alexzirnea/bldc_motor_driver_platform/README.md

# bldc_motor_driver_platform
Project repo for BLDC motor driver platform for ETTI
