alexzirnea/bldc_motor_driver_platform/Hardware/Specification/Connector_Pin_Mapping.xlsx

 | BLDC Motor Control Platform Interconnect Specification
Connector Type: PATA 40 Pin 2.54mm pin pitch
 |  | 2 | 4 | 6 | 8 | 10 | 12 | 14 | 16 | 18 | 20 | 22 | 24 | 26 | 28 | 30 | 32 | 34 | 36 | 38 | 40
Female connector |  | PWMAH | PWMBH | PWMCH | SCL | TX | MOSI | LEDR | LEDB | SW1 | HALLA | HALLC | VDD | DGND | TEMP | VBUS | IPHC | IPHA | VPHC | VPHA | AVDD
Board side view |  | PWMAL | PWMBL | PWMCL | SDA | RX | MISO | LEDG | CS2 | SW2 | HALLB | CS | SCK | GPIO | INT | POT | RST | IPHB | VGND | VPHB | AGND
 |  | 1 | 3 | 5 | 7 | 9 | 11 | 13 | 15 | 17 | 19 | 21 | 23 | 25 | 27 | 29 | 31 | 33 | 35 | 37 | 39
