alexzirnea/bldc_motor_driver_platform/Hardware/PIM/ATMEGA_4808/Renders/3D_SIDE.PNG

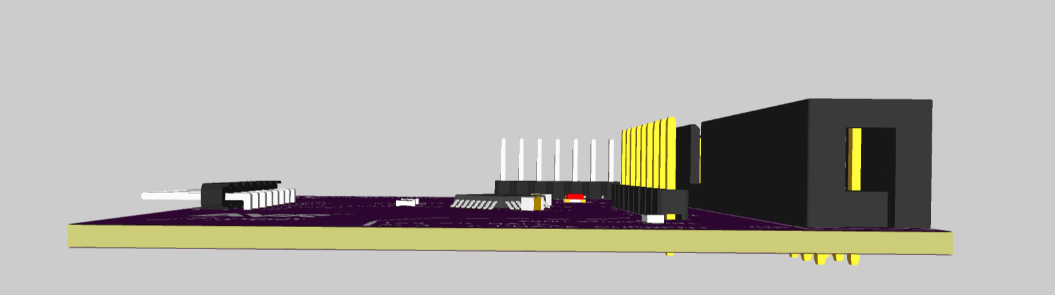
Hardware/PIM/ATMEGA_4808/Renders/3D_SIDE.PNG
