alexzirnea/bldc_motor_driver_platform/Hardware/PIM/ATMEGA_4808/Renders/3D_TOP.PNG

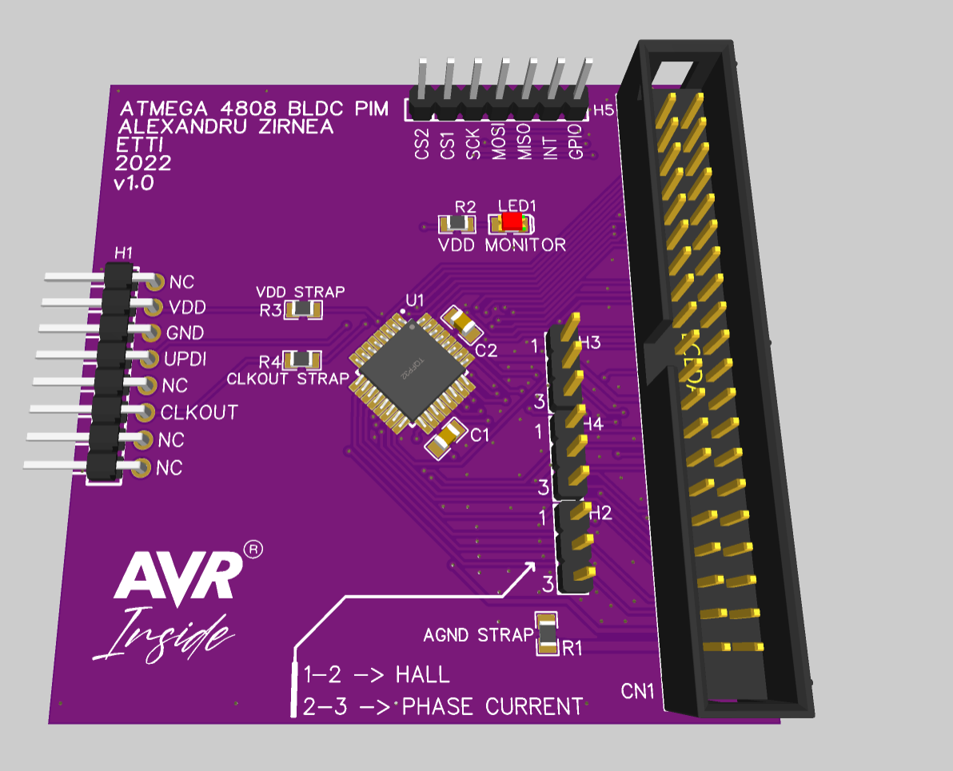
Hardware/PIM/ATMEGA_4808/Renders/3D_TOP.PNG
