alexzirnea/bldc_motor_driver_platform/Hardware/PIM/ESP32-WROOM-32E/Renders/3D_BOTTOM.PNG

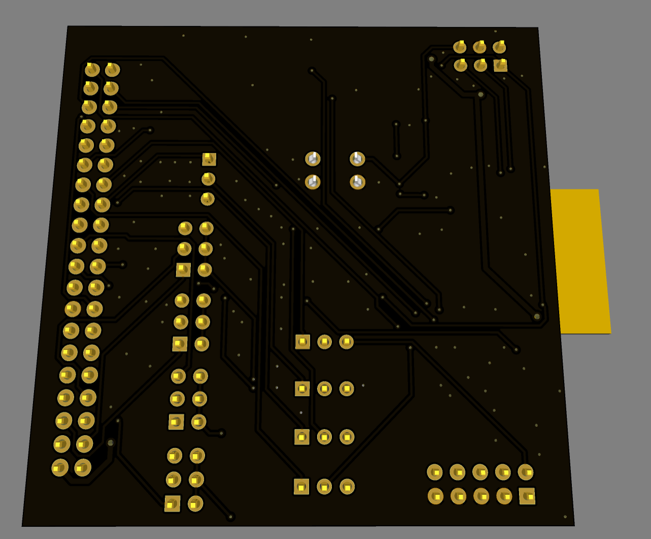
Hardware/PIM/ESP32-WROOM-32E/Renders/3D_BOTTOM.PNG
