alexzirnea/bldc_motor_driver_platform/Hardware/PIM/ESP32-WROOM-32E/Renders/3D_TOP.PNG

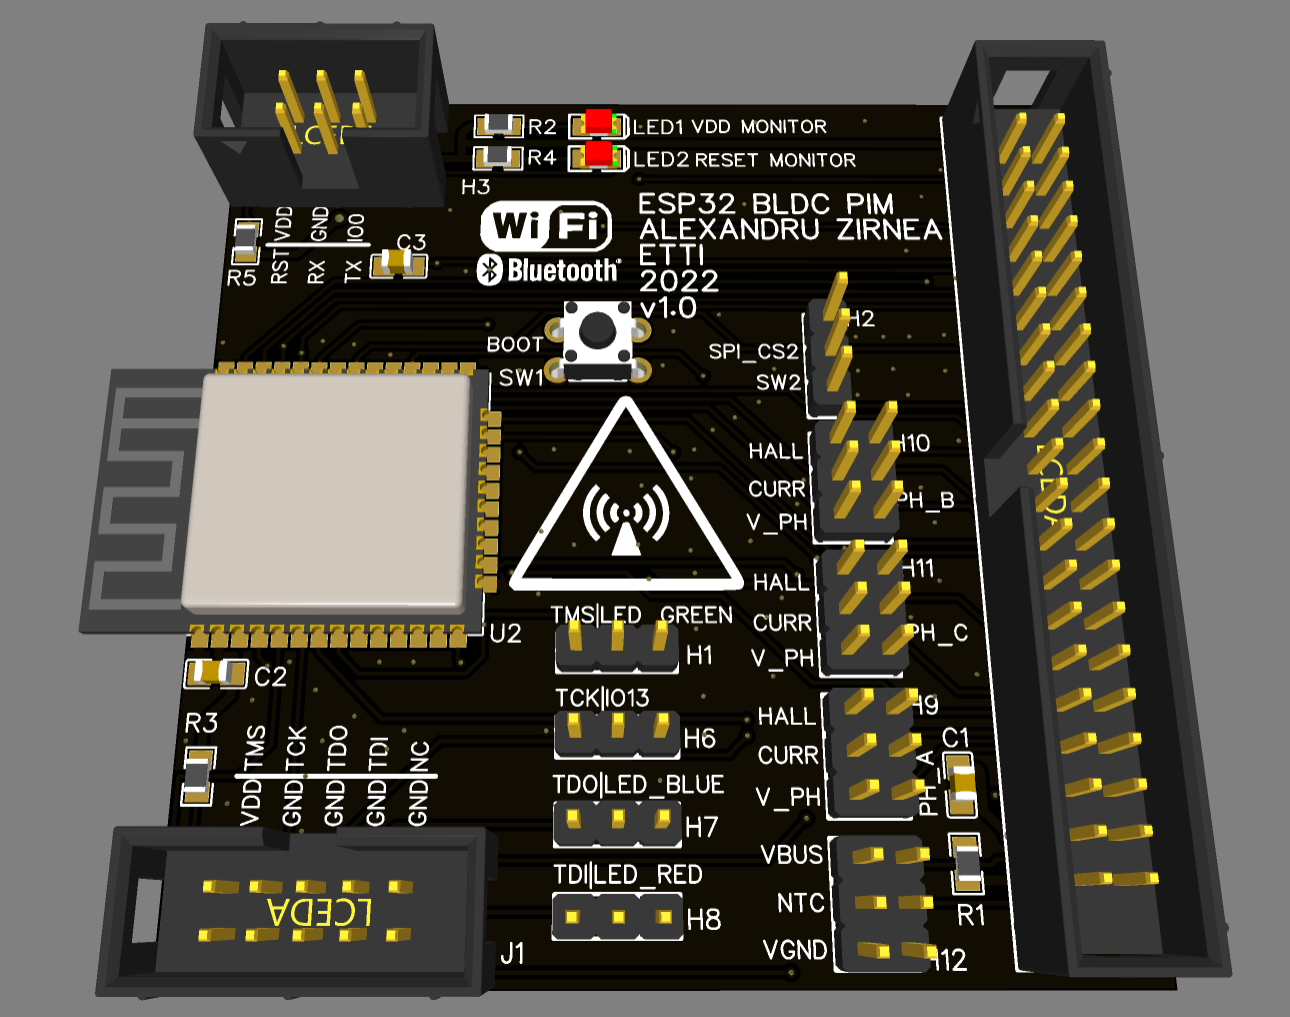
Hardware/PIM/ESP32-WROOM-32E/Renders/3D_TOP.PNG
