alexzirnea/bldc_motor_driver_platform/Hardware/OrCad Project/power_board/BOM.xlsx

ID | Value/Name | Fooprint | Designator | Quantity | Manufacturer Part | Manufacturer | Supplier | Supplier Part | Price[RON] | DNP
1 | 1n | SMC0805 | C1,C2,C3,C4,C5,C6,C43,C46,C52,C55,C59 | 11 | 885012207098 | WURTH Elektronik | MOUSER | 710-885012207098 | 0.495
2 | 100n | SMC0805 | C7,C8,C9,C10,C23,C27,C30,C33,C36,C47 | 10 | 885012107015 | WURTH Elektronik | MOUSER | 710-885012107015 | 0.495
3 | 10u | CAPC5750X330N | C11,C12,C13,C14,C15,C16,C17,C18,C19,C20,C21,C22,C42,C51 | 14 | 22201C106KAT2A | Kyocera AVX | MOUSER | 581-22201C106KAT2A | 10.2
4 | 1u | SMC0805 | C24,C25,C26,C44,C45,C53,C54 | 7 | 885012107015 | WURTH Elektronik | MOUSER | 710-885012107015 | 0.495
5 | 1u | SMC0805 | C50 | 1 | CGA4J3X7S2A105KS | TDK | MOUSER | 810-CGA4J3X7S2A105KS | 2.03
6 | 47u | SMC1206 | C28,C31,C34,C48,C58 | 5 | CL31A476MQHNNNE | Samsung Electro-Mechanics | MOUSER | 187-CL31A476MQHNNNE | 1.58
7 | 10u | SMC0805 | C29,C32,C35 | 3 | CL21A106KAYNNNF | Samsung Electro-Mechanics | MOUSER | 187-CL21A106KAYNNNF | 0.941
8 | 2.2u | SMC0805 | C37,C41 | 2 | CL21A225KAFNNNG | Samsung Electro-Mechanics | MOUSER | 187-CL21A225KAFNNNG | 0.594
9 | 560u | CAP_EEEFT1V561AP | C38,C49 | 2 | EEE-FT1V561AP | Panasonic | MOUSER | 667-EEE-FT1V561AP | 7.62
10 | 10n | SMC0805 | C39,C40 | 2 | 08051C103KAT2A | KEMET | MOUSER | 581-08051C103K | 0.594
11 | 2200u 63V | UPW1J222MHD | C56,C57 | 2 | UPW1J222MHD | Nichicon | MOUSER | 647-UPW1J222MHD | 17.87
12 | BAT54 | SMSOT23123 | DN1,DN2,DN3,DN4 | 4 | BAT54S-QR | Nexperia | MOUSER | 771-BAT54S-QR | 0.941
13 | MBRS1100T3G | DIOM5436X247N | D1,D2,D3 | 3 | MBRS1100T3G | onsemi | MOUSER | 863-MBRS1100T3G | 2.87
14 | LL-R3528RGBC-008-B | LED_LL-R3528RGBC-008-B | D4 | 1 | AAA3528LSEKJ3ZGKQBKS | Kingbright | MOUSER | 604-AAA3528LSEKJ3ZGK | 4.41
15 | LED | SMD0805 | D5,D6,D7,D8,D9,D10,D21,D22,D23,D24,D25 | 11 | 150080GS75000 | WURTH Elektronik | MOUSER | 710-150080GS75000 | 0.941
16 | SS26FL | DIO_SS26FL | D11,D12,D13,D14,D15,D16 | 6 | SS26FL | onsemi | MOUSER | 512-SS26FL | 1.78
17 | BAT41 | SOD3716X135N | D17,D19 | 2 | BAT41ZFILM | ST Microelectronics | MOUSER | 511-BAT41ZFILM | 1.78
18 | MMSZ7V5T1G | SOD3716X135N | D18 | 1 | MMSZ7V5T1G | onsemi | MOUSER | 863-MMSZ7V5T1G | 1.14
19 | 15KP48CA | DIOAD885W125L910D885 | D20 | 1 | 15KP48CA-TP | MCC | MOUSER | 833-15KP48CA-TP | 62.22
20 | INA240A2EDRQ1 | SOIC127P600X175-8N | IC1,IC2,IC3 | 3 | INA240A2EDRQ1 | Texas Instruments | MOUSER | 595-INA240A2EDRQ1 | 21.48
21 | MIC4104YM | SOIC127P599X173-8N | IC4,IC5,IC6 | 3 | MIC4104YM | Microchip Technology | MOUSER | 998-MIC4104YM | 14.11
22 | MCP16331T-E_CH | SOT95P280X145-6N | IC7 | 1 | MCP16331T-E/CH | Microchip Technology | MOUSER | 579-MCP16331T-E/CH | 8.81
23 | PHASE A | power_pad | J1 | 1 | N/A - Connection wires | N/A - Connection wires | N/A - Connection wires | N/A - Connection wires | 0
24 | PHASE B | power_pad | J2 | 1 | N/A - Connection wires | N/A - Connection wires | N/A - Connection wires | N/A - Connection wires | 0
25 | PHASE C | power_pad | J3 | 1 | N/A - Connection wires | N/A - Connection wires | N/A - Connection wires | N/A - Connection wires | 0
26 | HEADER 1x2 | BLKCON100VHTM1SQW1002 | J4,J5,J6,J32,J33,J34,J37,J39 | 8 | TSW-102-07-T-S | SAMTEC | MOUSER | 200-TSW10207TS | 0.792
27 | HEADER 4 | BLKCON100VHTM1SQW1004 | J7,J8 | 2 | 69190-404 | Amphenol FCI | MOUSER | 649-69190-404 | 1.24
28 | JUMPER1 | BLKCON100VHTM1SQW1002 | J9 | 1 | TSW-102-07-T-S | SAMTEC | MOUSER | 200-TSW10207TS | 0.792
29 | CON6 | BLKCON100RHTM1SQW4256 | J10 | 1 | 77313-446-06LF | Amphenol FCI | MOUSER | 649-77313-446-06LF | 1.49
30 | 30340-5002HB | BLKCON100VHTM2OEW20040 | J11 | 1 | 61204021621 | WURTH Elektronik | MOUSER | 710-61204021621 | 5.99
31 | HEADER 4X2 | BLKCON100VHTM2OEW2008 | J12,J13,J14,J15,J17 | 5 | 79425-408HLF | Amphenol FCI | MOUSER | 649-79425-408HLF | 1.63
32 | 10129381-906002BLF | HDRV6W67P254_2X3_762X483X858P | J16 | 1 | 77313-446-06LF | Amphenol FCI | MOUSER | 649-77313-446-06LF | 1.49
33 | CON5 | BLKCON100VHTM1SQW1005 | J18 | 1 | 54101-T06-05 | Amphenol FCI | MOUSER | 649-54101-T06-05 | 1.09
34 | CON3 | BLKCON100VHTM1SQW1003 | J19,J20,J21,J22 | 4 | 61300311121 | WURTH Elektronik | MOUSER | 710-61300311121 | 0.644
35 | CON1 | BLKCON100VHTM1SQW1001 | J23,J25,J26,J27,J28,J29,J30 | 7 | 4952 | Keystone | MOUSER | 534-4952 | 1.29
36 | HEADER 5X2 | BLKCON100VHTM2OEW20010 | J24 | 1 | 61201021621 | WURTH Elektronik | MOUSER | 710-61201021621 | 2.38
37 | CON11 | ili9341_2_8inch | J31 | 1 | 801-83-011-10-001101 | SAMTEC | MOUSER | 437-8018301110001101 | 9.41
38 | VIN | power_pad | J35 | 1 | N/A - Connection wires | N/A - Connection wires | N/A - Connection wires | N/A - Connection wires | 0
39 | GND | power_pad | J36 | 1 | N/A - Connection wires | N/A - Connection wires | N/A - Connection wires | N/A - Connection wires | 0
40 | HEADER 3 | BLKCON100VHTM1SQW1003 | J38 | 1 | 61300311121 | WURTH Elektronik | MOUSER | 710-61300311121 | 0.644
41 | 100u | INDM1250X1250X600 | L1 | 1 | SLF12575T-101M1R9-PF | TDK | MOUSER | 810-SLF12575T-101M | 9.95
42 | 100uH | INDP125125X785N | L2 | 1 | SLF12575T-101M1R9-PF | TDK | MOUSER | 810-SLF12575T-101M | 9.95
43 | IPB039N10N3_G | PG-TO263-3 | Q1,Q2,Q3,Q4,Q5,Q6 | 6 | IPB039N10N3G | Infineon | MOUSER | 726-IPB039N10N3G | 17.18
44 | 10k NTC | SMR0805 | RT1 | 1 | NTCS0805E3103HLT | Vishay | MOUSER | 594-NTCS0805E3103HLT | 3.56
45 | 47k | SMR0805 | R1,R2,R3,R4,R5,R6,R79,R80 | 8 | 667-ERJ-6ENF4702V | Panasonic | MOUSER | 667-ERJ-6ENF4702V | 0.495
46 | 5.1k | SMR0805 | R7,R8,R9,R81 | 4 | CRCW08055K10FKEA | Vishay | MOUSER | 71-CRCW0805-5.1K-E3 | 0.495
47 | 3.3R | SMR1210 | R10,R13,R15 | 3 | RK73B2ETTD3R3J | KOA Speer | MOUSER | 660-RK73B2ETTD3R3J | 0.945
48 | 110k | SMR0805 | R11,R12,R14,R71,R72 | 5 | CR0805FX-1103ELF | Bourns | MOUSER | 652-CR0805FX-1103ELF | 0.495
49 | 1k | SMR0805 | R16,R17,R74 | 3 | CRT0805FZ1001ELF | Bourns | MOUSER | 652-CRT0805FZ1001ELF | 0.495
50 | 2k2 | SMR0805 | R18,R20,R21 | 3 | CR0805JW-222ELF | Bourns | MOUSER | 652-CR0805JW-222ELF | 0.495
51 | 3k3 | SMR0805 | R19,R22,R23 | 3 | CRCW08053K30JNEB | Vishay | MOUSER | 71-CRCW08053K30JNEB | 0.495
52 | 10k | SMR0805 | R24,R29,R32,R40,R48,R49,R55,R56,R61,R62,R68,R73 | 12 | CRGCQ0805F10K | TE Connectivity | MOUSER | 279-CRGCQ0805F10K | 0.495
53 | 330R | SMR0805 | R25,R26,R27,R30,R31,R33,R34,R35,R36,R75,R76,R77,R78 | 13 | RC0805FR-07330RL | YAGEO | MOUSER | 603-RC0805FR-07330RL | 0.495
54 | 10k | RK09D117000B | R28 | 1 | RK09D117000B | Alps | MOUSER | 688-RK09D117000B | 10.15
55 | 0.001R | CSS2H-3920R | R37,R38,R39 | 3 | CSS2H-3920R-1L00F | Bourns | MOUSER | 652-CSS2H3920R1L00F | 6.29
56 | 0R | SMR0805 | R41,R42,R43 | 3 | CR0805-J/-000ELF | BOURNS | MOUSER | 652-CR0805-J/-000ELF | 0.495
57 | 20R | SMR0805 | R44,R47,R52,R57,R60,R65 | 6 | RC0805FR-0720RL | YAGEO | MOUSER | 603-RC0805FR-0720RL | 0.495
58 | 5R | SMR0805 | R45,R50,R53,R58,R63,R66 | 6 | CR0805-J/-5R1ELF | BOURNS | MOUSER | 652-CR0805-J/-5R1ELF | 0.495
59 | 330k | SMR0805 | R46,R51,R54,R59,R64,R67 | 6 | AC0805FR-07330KL | YAGEO | MOUSER | 603-AC0805FR-07330KL | 0.495
60 | 402k | SMR0805 | R69 | 1 | CR0805FX-4023ELF | BOURNS | MOUSER | 652-CR0805FX-4023ELF | 0.495
61 | 2k | SMR0805 | R70 | 1 | CR0805AFX2001EAS | BOURNS | MOUSER | 652-CR0805AFX2001EAS | 0.495
62 | B3F-1000 | SW_B3F-1000 | SW1,SW2,SW3 | 3 | TS02-66-55-BK-100-LCR-D | CUI Devices | MOUSER | 179-TS026655BK100LCR | 0.495
63 | NRF24L01P-MODULE-PCB | XCVR_NRF24L01P-MODULE-PCB | U1 | 1 | CES-104-02-T-D | Samtec | MOUSER | 200-CES10402TD | 6.09
64 | LM5161PWPR | IC_TPS27S100BPWPR | U2 | 1 | LM5161PWPR | Texas Instruments | MOUSER | 595-LM5161PWPR | 24.21
65 | AMS1117-5V | SOT229P700X180-4N | U3 | 1 | LDL1117S50R | ST Microelectronics | MOUSER | 511-LDL1117S50R | 5.74
66 | AMS1117-33 | SOT229P700X180-4N | U4 | 1 | LDL1117S33R | ST Microelectronics | MOUSER | 511-LDL1117S33R | 5.74
