alexzirnea/bldc_motor_driver_platform/Hardware/PIM/ATMEGA_4808/BOM.xlsx

ID | Name | Designator | Footprint | Quantity | Manufacturer Part | Manufacturer | Supplier | Supplier Part | Price[RON] | DNP
1 | 0.1u | C1,C2 | C0805 | 2 | 885012207098 | WURTH Elektronik | MOUSER | 710-885012207098 | 0.495
2 | CS-1200-40(L11.6)6T | CN1 | CONN-TH_40P-P2.54_CST_CS-1200-40XXX6T | 1 | 61204021621 | WURTH Elektronik | MOUSER | 710-61204021621 | 5.99
3 | MPLAB SNAP 2.54 HORIZ MALE | H1 | HDR-TH_8P-P2.54-H-M-W10.4-N | 1 | 10129379-908001BLF | Amphenol FCI | MOUSER | 649-1012937990801BLF | 1.14
4 | KH-2.54FH-1X3P-H8.5 | H2,H3,H4 | HDR-TH_3P-P2.54-V-F | 3 | 61300311121 | WURTH Elektronik | MOUSER | 710-61300311121 | 0.644
5 | KH-2.54FH-1X7P-H8.5 | H5 | HDR-TH_7P-P2.54-V-F | 1 | 10129379-907001BLF | Amphenol FCI | MOUSER | 649-1012937990701BLF | 1.09
6 | LED-0603_R | LED1 | LED0805_RED | 1 | 150080RS75000 | WURTH Elektronik | MOUSER | 710-150080RS75000 | 0.941
7 | 0R | R1 | R0805 | 1 | CR0805-J/-000ELF | BOURNS | MOUSER | 652-CR0805-J/-000ELF | 0.495
8 | 330R | R2 | R0805 | 1 | RC0805FR-07330RL | YAGEO | MOUSER | 603-RC0805FR-07330RL | 0.495
9 | 0R | R3,R4 | R0805 | 2 | CR0805-J/-000ELF | BOURNS | MOUSER | 652-CR0805-J/-000ELF | 0.495 | TRUE
10 | ATmega4808-AFR | U1 | 32-TQFP | 1 | ATMEGA4808-AFR | Microchip | MOUSER | 579-ATMEGA4808AFR | 9.31
