alexzirnea/bldc_motor_driver_platform/Hardware/PIM/ESP32-WROOM-32E/BOM.xlsx

ID | Name | Designator | Footprint | Quantity | Manufacturer Part | Manufacturer | Supplier | Supplier Part | Price[RON] | DNP
1 | 1u | C1,C2 | C0805 | 2 | 885012107015 | WURTH Elektronik | MOUSER | 710-885012107015 | 0.495
2 | 0.1u | C3 | C0805 | 1 | 885012207098 | WURTH Elektronik | MOUSER | 710-885012207098 | 0.495
3 | CS-1200-40(L11.6)6T | CN1 | CONN-TH_40P-P2.54_CST_CS-1200-40XXX6T | 1 | 61204021621 | WURTH Elektronik | MOUSER | 710-61204021621 | 5.99
4 | KH-2.54FH-1X3P-H8.5 | H1,H2,H6,H7,H8 | HDR-TH_3P-P2.54-V-F | 5 | 61300311121 | WURTH Elektronik | MOUSER | 710-61300311121 | 0.644
5 | 210-72-03GB01 | H3 | HDR-TH_6P-P2.54-V-R2-C3-S2.54_A2541WV-2X3P | 5 | 61200621621 | WURTH Elektronik | MOUSER | 710-61200621621 | 2.38
6 | 210-72-03GB01 | H9,H10,H11,H12 | HDR-TH_6P-P2.54-V-R2-C3-S2.54_A2541WV-2X3P | 5 | 77313-446-06LF | Amphenol FCI | MOUSER | 649-77313-446-06LF | 1.49
7 | F185-1210A0BSYA1 | J1 | H2X5-2.54 | 1 | 61201021621 | WURTH Elektronik | MOUSER | 710-61201021621 | 2.38
8 | LED-0603_R | LED1,LED2 | LED0805_RED | 2 | 150080RS75000 | WURTH Elektronik | MOUSER | 710-150080RS75000 | 0.941
9 | 0R | R1 | R0805 | 1 | CR0805-J/-000ELF | BOURNS | MOUSER | 652-CR0805-J/-000ELF | 0.495
10 | 330R | R2,R4 | R0805 | 2 | RC0805FR-07330RL | YAGEO | MOUSER | 603-RC0805FR-07330RL | 0.495
11 | 0R | R3,R5 | R0805 | 2 | CR0805-J/-000ELF | BOURNS | MOUSER | 652-CR0805-J/-000ELF | 0.495 | TRUE
12 | TSC016A03526A | SW1 | KEY-TH_4P-L4.5-W4.5-P3.00-LS5.8 | 1 | TS02-66-55-BK-100-LCR-D | CUI Devices | MOUSER | 179-TS026655BK100LCR | 0.495
13 | ESP32-WROOM-32 | U2 | WIFIM-SMD_ESP-32S | 1 | ESP32-WROOM-32E-N4 | Espressif Systems | MOUSER | 356-ESP32WRM32E132PH | 14.85
