alexzirnea/bldc_motor_driver_platform/Hardware/OrCad Project/parts/B3F-1000.STEP

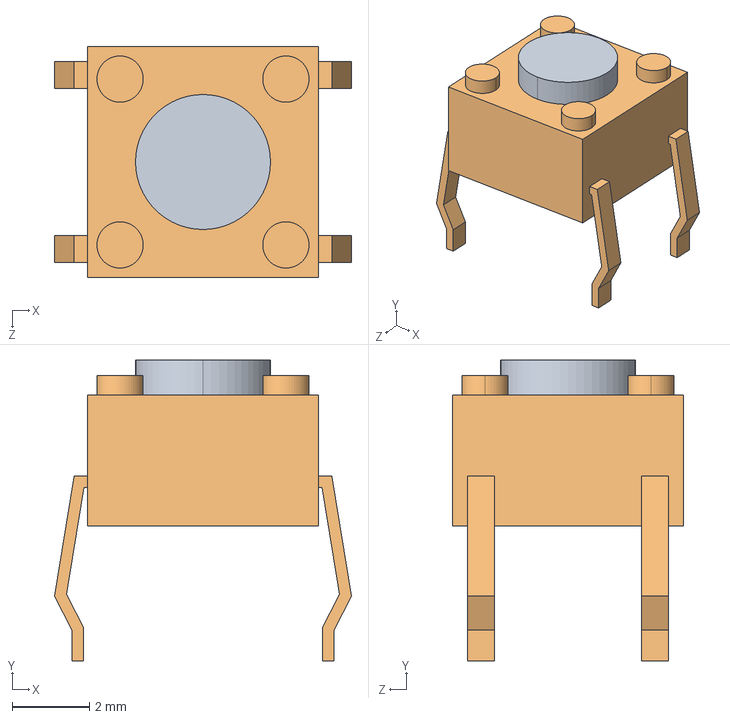
[picture p7: CAD file, 2022-05-20]
Hardware/OrCad Project/parts/B3F-1000.STEP
7.70 x 7.80 x 6.00 mm
B3F_1000_BUTTON
B3F_1000_BASE
