alexzirnea/bldc_motor_driver_platform/Hardware/OrCad Project/parts/DIOAD885W125L910D885.STEP

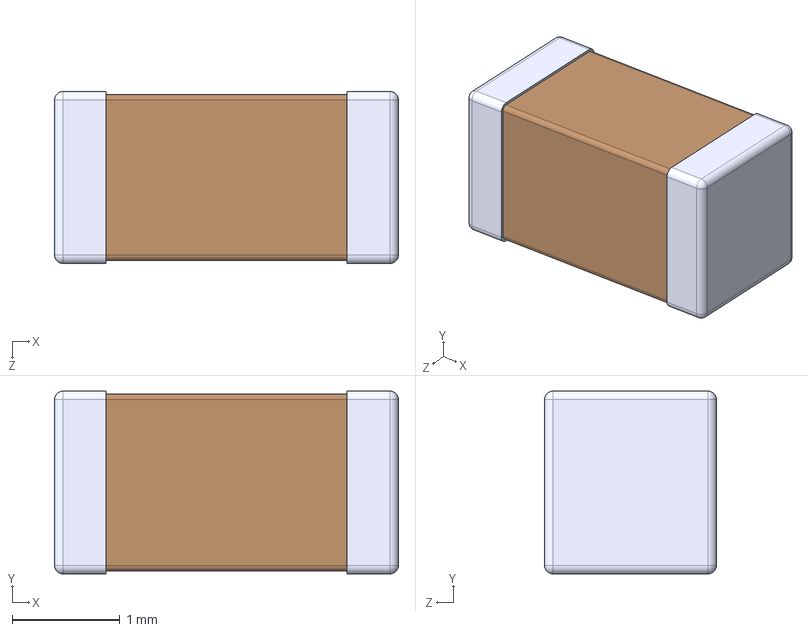
[picture p8: CAD file, 2022-05-19]
Hardware/OrCad Project/parts/DIOAD885W125L910D885.STEP
3.20 x 1.70 x 1.60 mm
