alexzirnea/bldc_motor_driver_platform/Hardware/OrCad Project/parts/LM5161PWPR.STEP

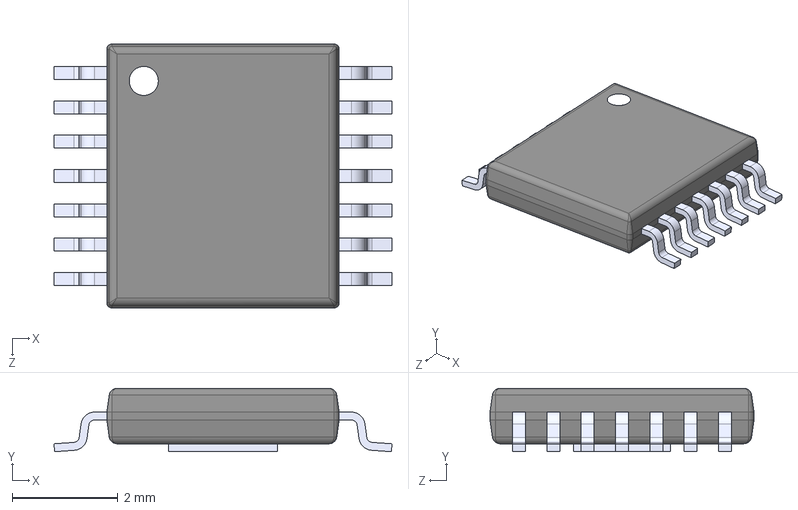
[picture p9: CAD file, 2022-05-16]
Hardware/OrCad Project/parts/LM5161PWPR.STEP
6.40 x 1.20 x 5.00 mm
