alexzirnea/bldc_motor_driver_platform/Hardware/OrCad Project/parts/AMS1117-3.3.STEP

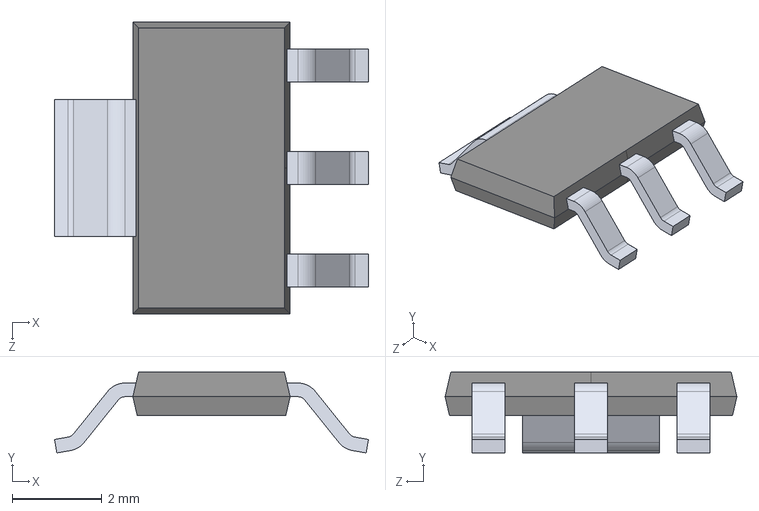
[picture p10: CAD file, 2022-05-16]
Hardware/OrCad Project/parts/AMS1117-3.3.STEP
7.00 x 1.80 x 6.50 mm
