alexzirnea/bldc_motor_driver_platform/Hardware/OrCad Project/parts/LL-R3528RGBC-008-B.STEP

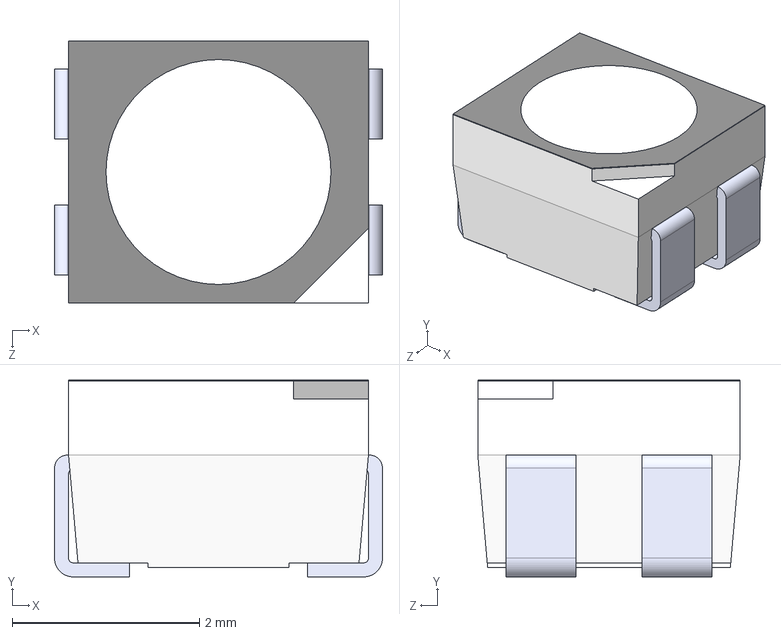
[picture p11: CAD file, 2022-05-16]
Hardware/OrCad Project/parts/LL-R3528RGBC-008-B.STEP
3.50 x 2.10 x 2.80 mm
