alexzirnea/bldc_motor_driver_platform/Hardware/OrCad Project/parts/EEU-FR1C101.stp

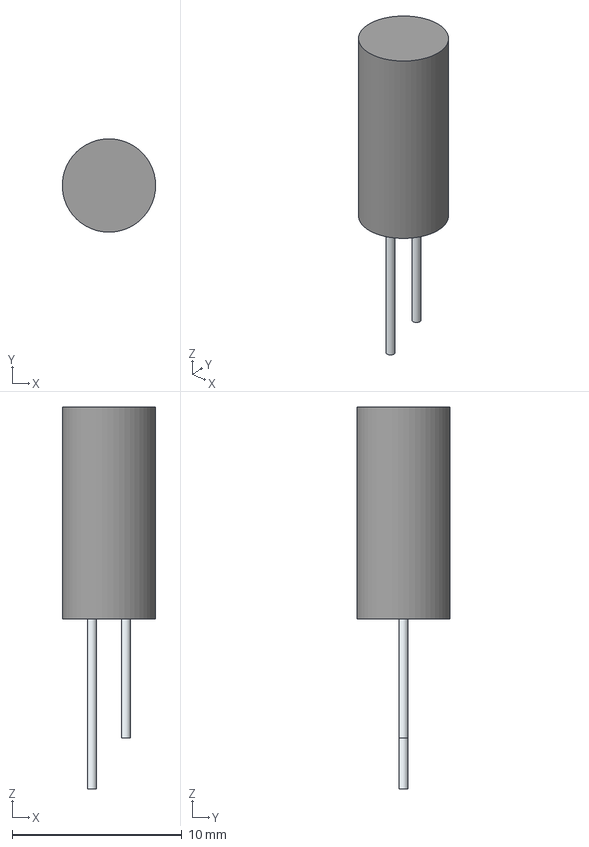
[picture p12: CAD file, 2022-04-29]
Hardware/OrCad Project/parts/EEU-FR1C101.stp
5.49 x 5.50 x 22.5 mm
SimpleBody
Pin1
Pin2
