alexzirnea/bldc_motor_driver_platform/Hardware/OrCad Project/parts/BAT41ZFILM.stp

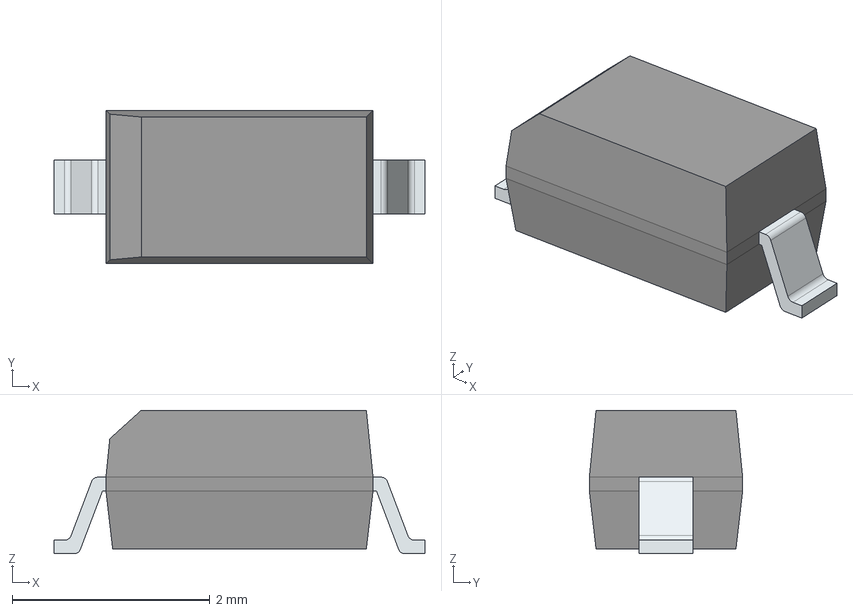
[picture p13: CAD file, 2022-04-29]
Hardware/OrCad Project/parts/BAT41ZFILM.stp
3.75 x 1.55 x 1.45 mm
FilletPinL
FilletPinR
