alexzirnea/bldc_motor_driver_platform/Hardware/OrCad Project/parts/AVR128DA48T-E_PT.stp

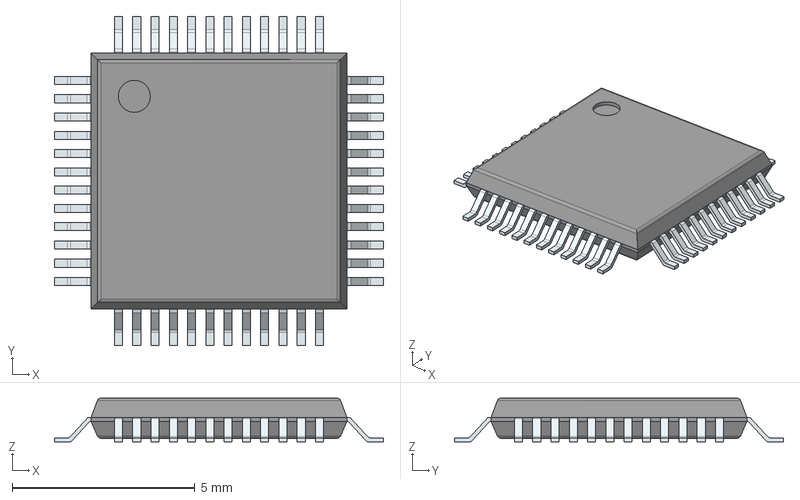
[picture p14: CAD file, 2022-04-29]
Hardware/OrCad Project/parts/AVR128DA48T-E_PT.stp
9.00 x 9.00 x 1.20 mm
PinsArrayLR
PinsArrayTB
