alexzirnea/bldc_motor_driver_platform/Hardware/OrCad Project/parts/B1047AS-680M=P3.stp

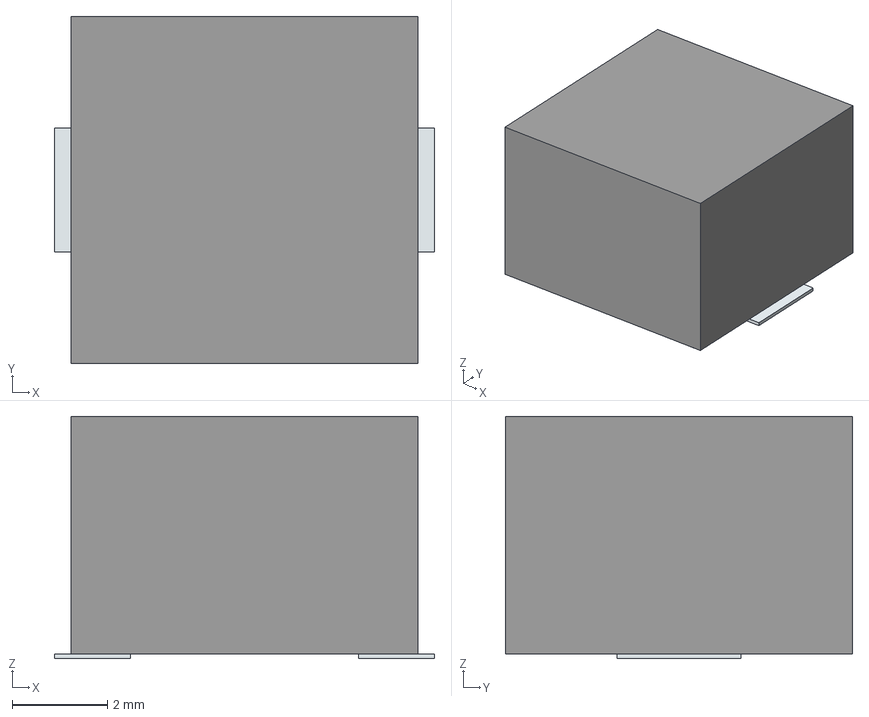
[picture p15: CAD file, 2022-04-29]
Hardware/OrCad Project/parts/B1047AS-680M=P3.stp
8.00 x 7.30 x 5.10 mm
Pins
