alexzirnea/bldc_motor_driver_platform/Hardware/OrCad Project/parts/CSS2H-3920K-4L00F.stp

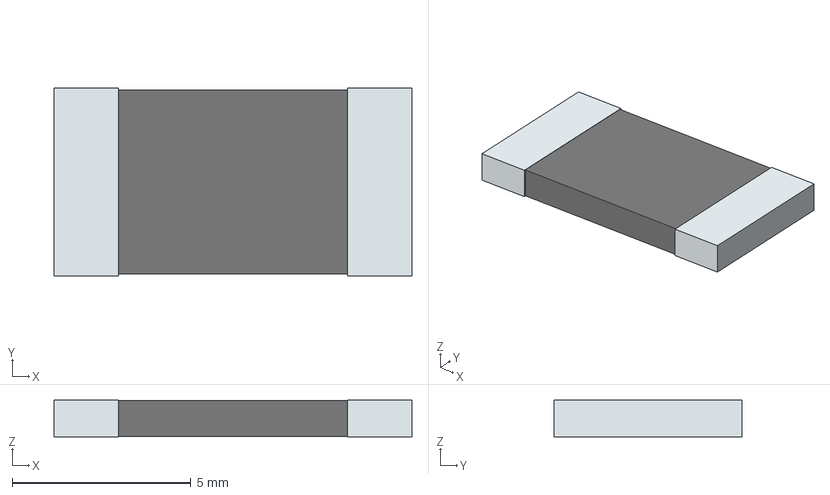
[picture p16: CAD file, 2022-04-29]
Hardware/OrCad Project/parts/CSS2H-3920K-4L00F.stp
10.0 x 5.25 x 1.02 mm
term1
term2
