alexzirnea/bldc_motor_driver_platform/Hardware/OrCad Project/parts/INA240A2EDRQ1.stp

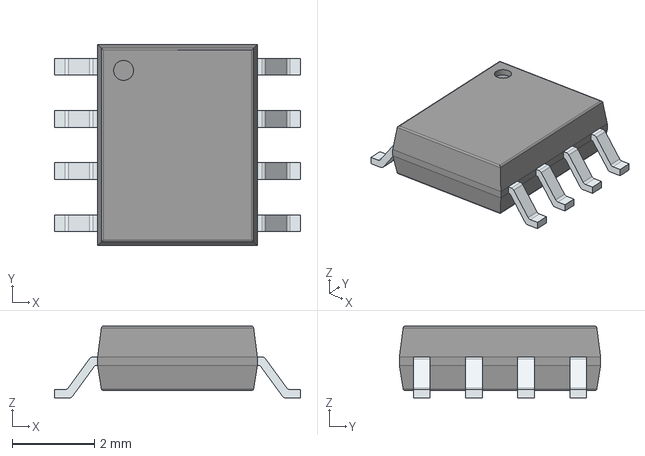
[picture p17: CAD file, 2022-04-29]
Hardware/OrCad Project/parts/INA240A2EDRQ1.stp
6.00 x 4.91 x 1.75 mm
PinsArrayLR
