alexzirnea/bldc_motor_driver_platform/Hardware/OrCad Project/parts/MMSZ7V5T1G.stp

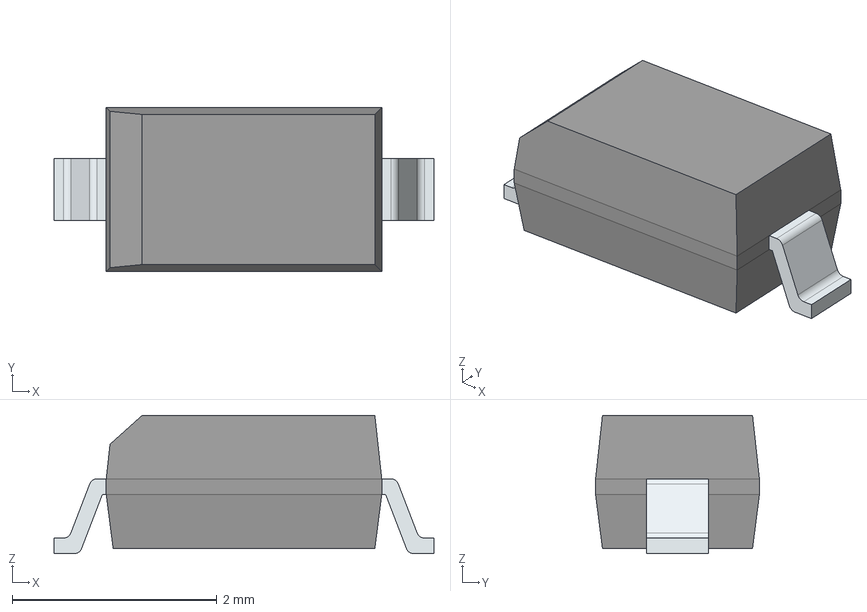
[picture p18: CAD file, 2022-04-29]
Hardware/OrCad Project/parts/MMSZ7V5T1G.stp
3.71 x 1.60 x 1.35 mm
FilletPinL
FilletPinR
