alexzirnea/bldc_motor_driver_platform/Hardware/OrCad Project/parts/SS26FL.stp

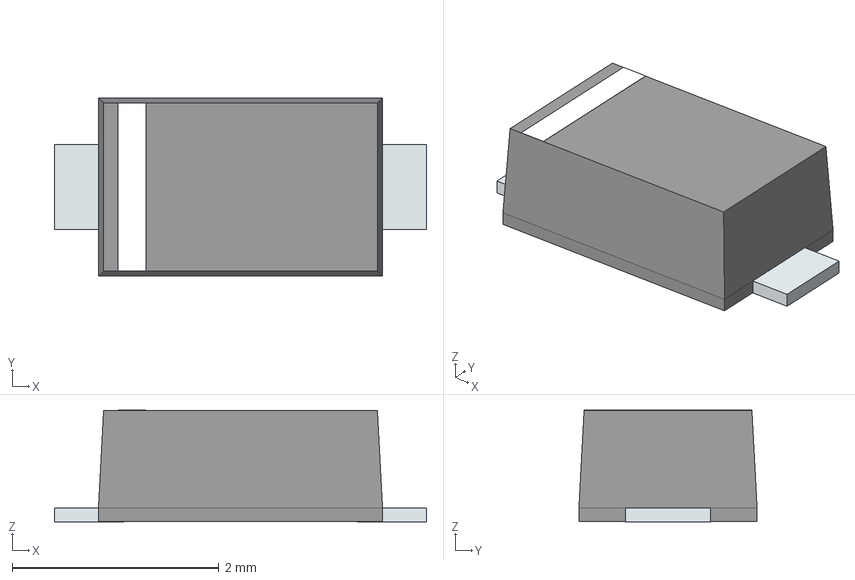
[picture p19: CAD file, 2022-04-29]
Hardware/OrCad Project/parts/SS26FL.stp
3.60 x 1.73 x 1.08 mm
PinKIdent
PinK
PinA
