alexzirnea/bldc_motor_driver_platform/Hardware/OrCad Project/parts/C3225X7R1C226M250AC.stp

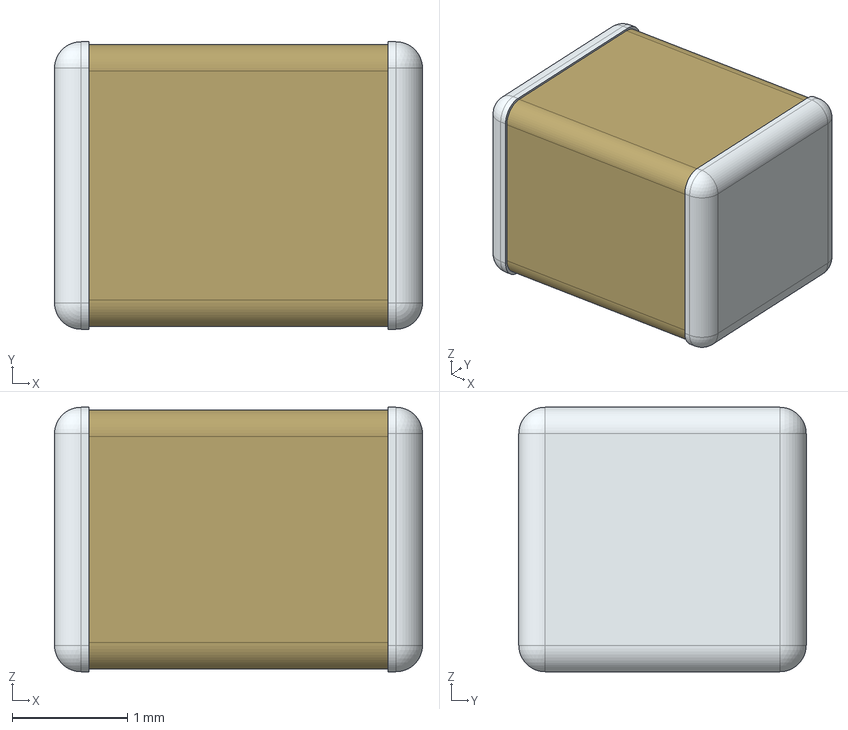
[picture p20: CAD file, 2022-04-29]
Hardware/OrCad Project/parts/C3225X7R1C226M250AC.stp
3.20 x 2.50 x 2.30 mm
