alexzirnea/bldc_motor_driver_platform/Hardware/OrCad Project/parts/UPW1J222MHD.stp

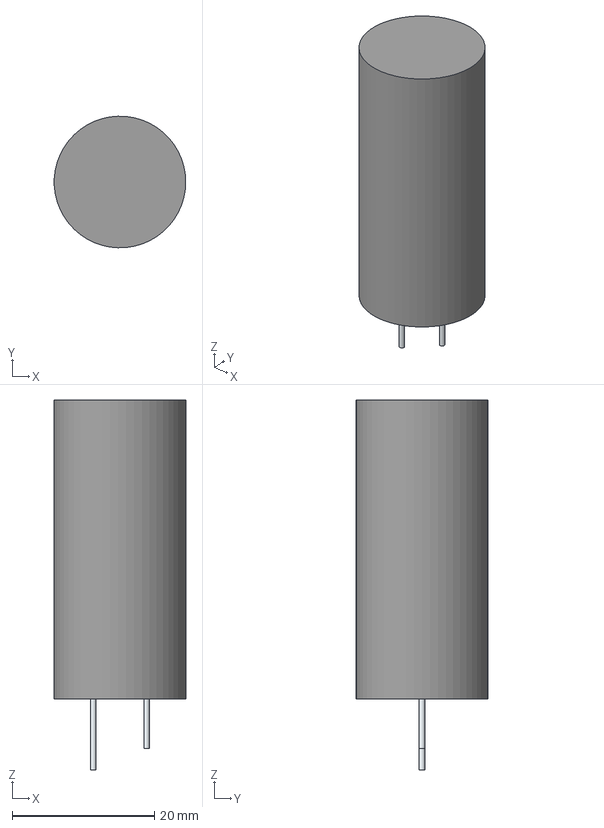
[picture p21: CAD file, 2022-04-29]
Hardware/OrCad Project/parts/UPW1J222MHD.stp
18.5 x 18.5 x 52.0 mm
SimpleBody
Pin1
Pin2
