alexzirnea/bldc_motor_driver_platform/Hardware/OrCad Project/parts/MIC4104YM.stp

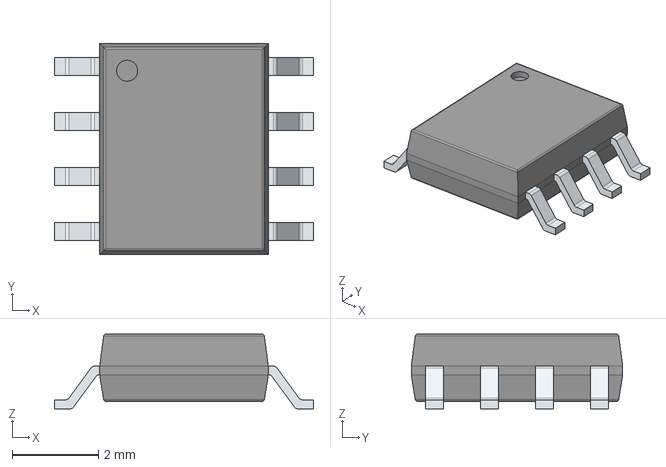
[picture p22: CAD file, 2022-04-29]
Hardware/OrCad Project/parts/MIC4104YM.stp
5.99 x 4.89 x 1.73 mm
PinsArrayLR
