alexzirnea/bldc_motor_driver_platform/Hardware/OrCad Project/parts/AP2012YD.stp

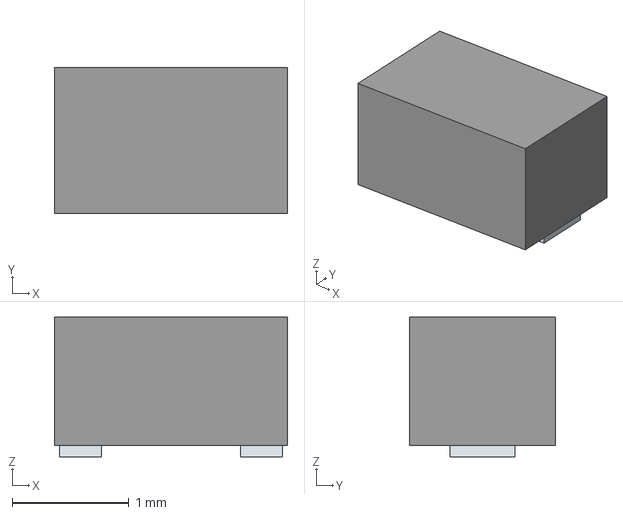
[picture p23: CAD file, 2022-04-29]
Hardware/OrCad Project/parts/AP2012YD.stp
2.00 x 1.25 x 1.20 mm
Pins
