alexzirnea/bldc_motor_driver_platform/Hardware/OrCad Project/parts/MBRS1100T3G.stp

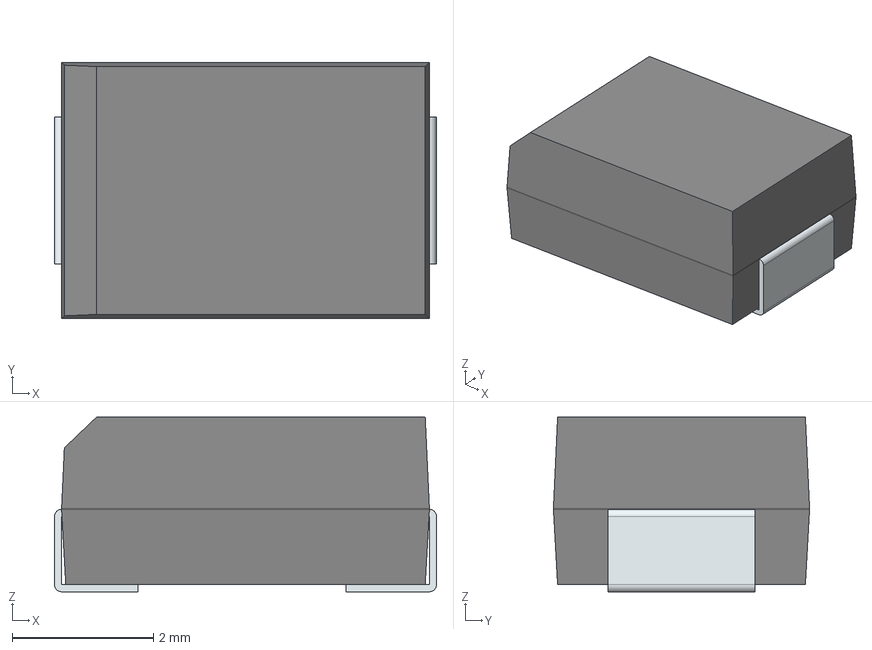
[picture p24: CAD file, 2022-04-29]
Hardware/OrCad Project/parts/MBRS1100T3G.stp
5.41 x 3.62 x 2.47 mm
FilletPin1
FilletPin2
