alexzirnea/bldc_motor_driver_platform/(list of files, cad)

Other CAD files:
Hardware/OrCad Project/parts/10129378-903001BLF.stl
Hardware/OrCad Project/parts/10129378-903001BLF.stp
Hardware/OrCad Project/parts/10129381-906002BLF.stl
Hardware/OrCad Project/parts/10129381-906002BLF.stp
Hardware/OrCad Project/parts/20_2x10_right_angle_connector.psm
Hardware/OrCad Project/parts/22205C105KAT1A.STEP
Hardware/OrCad Project/parts/30340-5002HB.stl
Hardware/OrCad Project/parts/30340-5002HB.stp
Hardware/OrCad Project/parts/3_pin_header_standard.psm
Hardware/OrCad Project/parts/5_pin_header_standard.psm
Hardware/OrCad Project/parts/67997-100HLF.stl
Hardware/OrCad Project/parts/67997-100HLF.stp
Hardware/OrCad Project/parts/6_pin_header_standard.psm
Hardware/OrCad Project/parts/AP2012YD.stl
Hardware/OrCad Project/parts/AVR128DA48T-E_PT.stl
Hardware/OrCad Project/parts/B1047AS-680M=P3.stl
Hardware/OrCad Project/parts/BAT41ZFILM.stl
Hardware/OrCad Project/parts/C3225X7R1C226M250AC.stl
Hardware/OrCad Project/parts/CSS2H-3920K-4L00F.stl
Hardware/OrCad Project/parts/EEU-FR1C101.stl
Hardware/OrCad Project/parts/INA240A2EDRQ1.stl
Hardware/OrCad Project/parts/MBRS1100T3G.stl
Hardware/OrCad Project/parts/MCP16331T-E_CH.stl
Hardware/OrCad Project/parts/MCP16331T-E_CH.stp
Hardware/OrCad Project/parts/MIC4104YM.stl
Hardware/OrCad Project/parts/MMSZ7V5T1G.stl
Hardware/OrCad Project/parts/SLF12575T-101M1R9-PF.STEP
Hardware/OrCad Project/parts/SS26FL.stl
Hardware/OrCad Project/parts/UPW1J222MHD.stl
Hardware/OrCad Project/parts/ap2012yd.psm
Hardware/OrCad Project/parts/b1047as-680m-p3.psm
Hardware/OrCad Project/parts/b1047as100mp3.psm
Hardware/OrCad Project/parts/cap_eeeft1v561ap.psm
Hardware/OrCad Project/parts/capc3225x230n.psm
Hardware/OrCad Project/parts/capc5750x229n.psm
Hardware/OrCad Project/parts/capc5750x330n.psm
Hardware/OrCad Project/parts/capprd200w55d500h1250.psm
Hardware/OrCad Project/parts/capprd750w80d1825h4200.psm
Hardware/OrCad Project/parts/css2h-3920r.psm
Hardware/OrCad Project/parts/dio_ss26fl.psm
Hardware/OrCad Project/parts/dioad885w125l910d885.psm
Hardware/OrCad Project/parts/diom5436x247n.psm
Hardware/OrCad Project/parts/eeu-fr1c101.psm
Hardware/OrCad Project/parts/hdrv2w67p254_2x1_254x483x858p.psm
Hardware/OrCad Project/parts/hdrv3w67p0x254_1x3_762x241x858p.psm
Hardware/OrCad Project/parts/hdrv6w67p254_2x3_762x483x858p.psm
Hardware/OrCad Project/parts/ic_tps27s100bpwpr.psm
Hardware/OrCad Project/parts/ili9341_2_8inch.psm
Hardware/OrCad Project/parts/indm1250x1250x600.psm
Hardware/OrCad Project/parts/indp125125x785n.psm
Hardware/OrCad Project/parts/led_ll-r3528rgbc-008-b.psm
Hardware/OrCad Project/parts/pg-to263-3.psm
Hardware/OrCad Project/parts/pg-to263-7-3_3.psm
Hardware/OrCad Project/parts/power_pad.psm
Hardware/OrCad Project/parts/qfp50p900x900x120-48n.psm
Hardware/OrCad Project/parts/resc10052x102n.psm
Hardware/OrCad Project/parts/rk09d117000b.psm
Hardware/OrCad Project/parts/shdrra40w64p254_2x20_5840x930x878p.psm
Hardware/OrCad Project/parts/sod3716x135n.psm
Hardware/OrCad Project/parts/sod3816x145n.psm
Hardware/OrCad Project/parts/sodfl3617x108n.psm
Hardware/OrCad Project/parts/sodfl3718x108n.psm
Hardware/OrCad Project/parts/soic127p599x173-8n.psm
Hardware/OrCad Project/parts/soic127p600x175-8n.psm
Hardware/OrCad Project/parts/sot229p700x180-4n.psm
Hardware/OrCad Project/parts/sot230p696x180-4n.psm
Hardware/OrCad Project/parts/sot230p700x180-4n.psm
Hardware/OrCad Project/parts/sot95p280x145-6n.psm
Hardware/OrCad Project/parts/sw_b3f-1000.psm
Hardware/OrCad Project/parts/upw1j222mhd.psm
Hardware/OrCad Project/parts/xcvr_nrf24l01p-module-pcb.psm
