alexzirnea/bldc_motor_driver_platform/Hardware/PIM/ATMEGA_4808/Schematic_ATMEGA4808_BLDC_PIM_2022-08-06.pdf

## VDD

AGND | GND

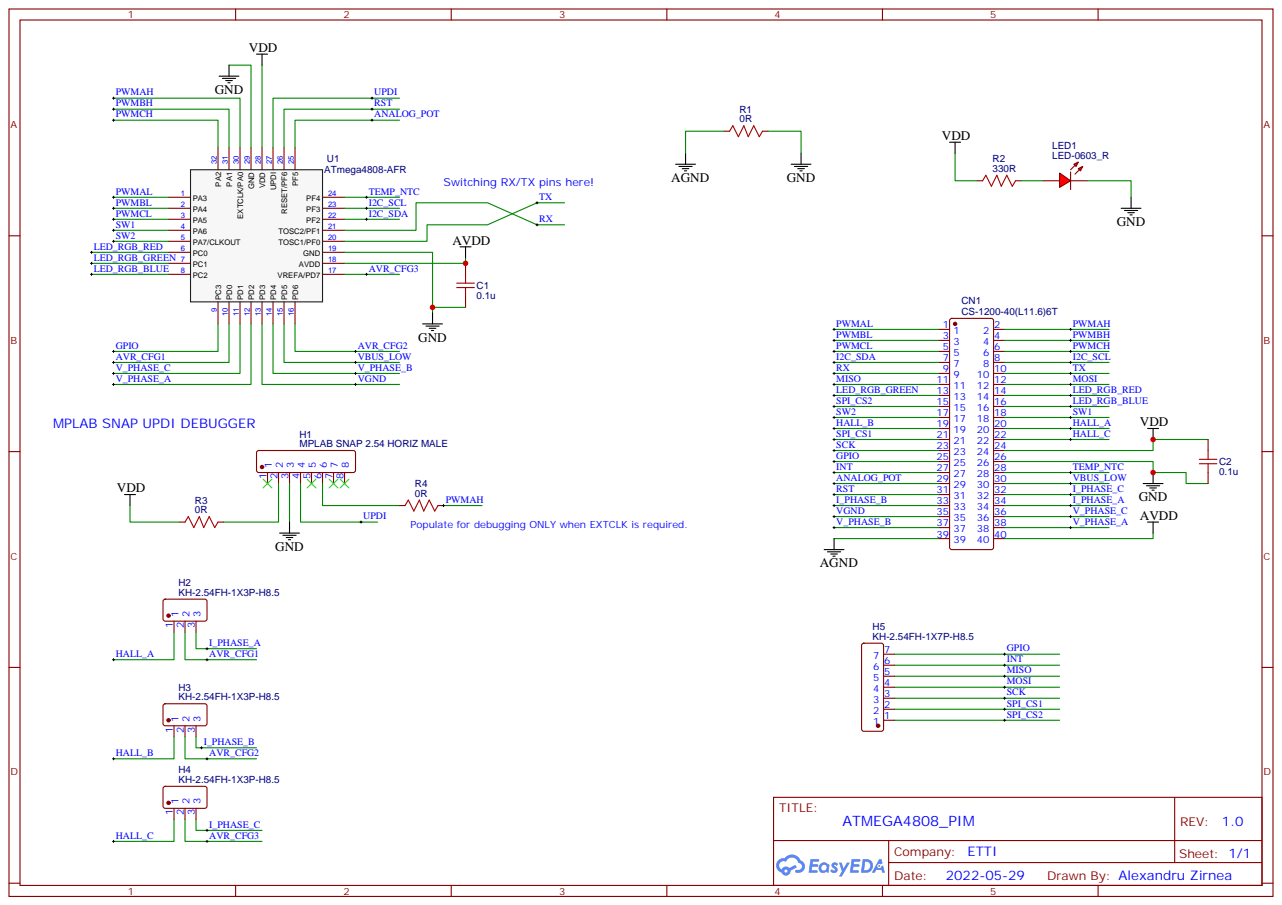
[picture p25: page 1]

Switching RX/TX pins here!

MPLAB SNAP UPDI DEBUGGER

MPLAB SNAP 2.54 HORIZ MALE

Populate for debugging ONLY when EXTCLK is required.

Drawn By: Alexandru Zirnea
