alexzirnea/bldc_motor_driver_platform/Hardware/PIM/ESP32-WROOM-32E/Schematic_ESP32_BLDC_PIM_2022-08-06.pdf

## VDD

## GND

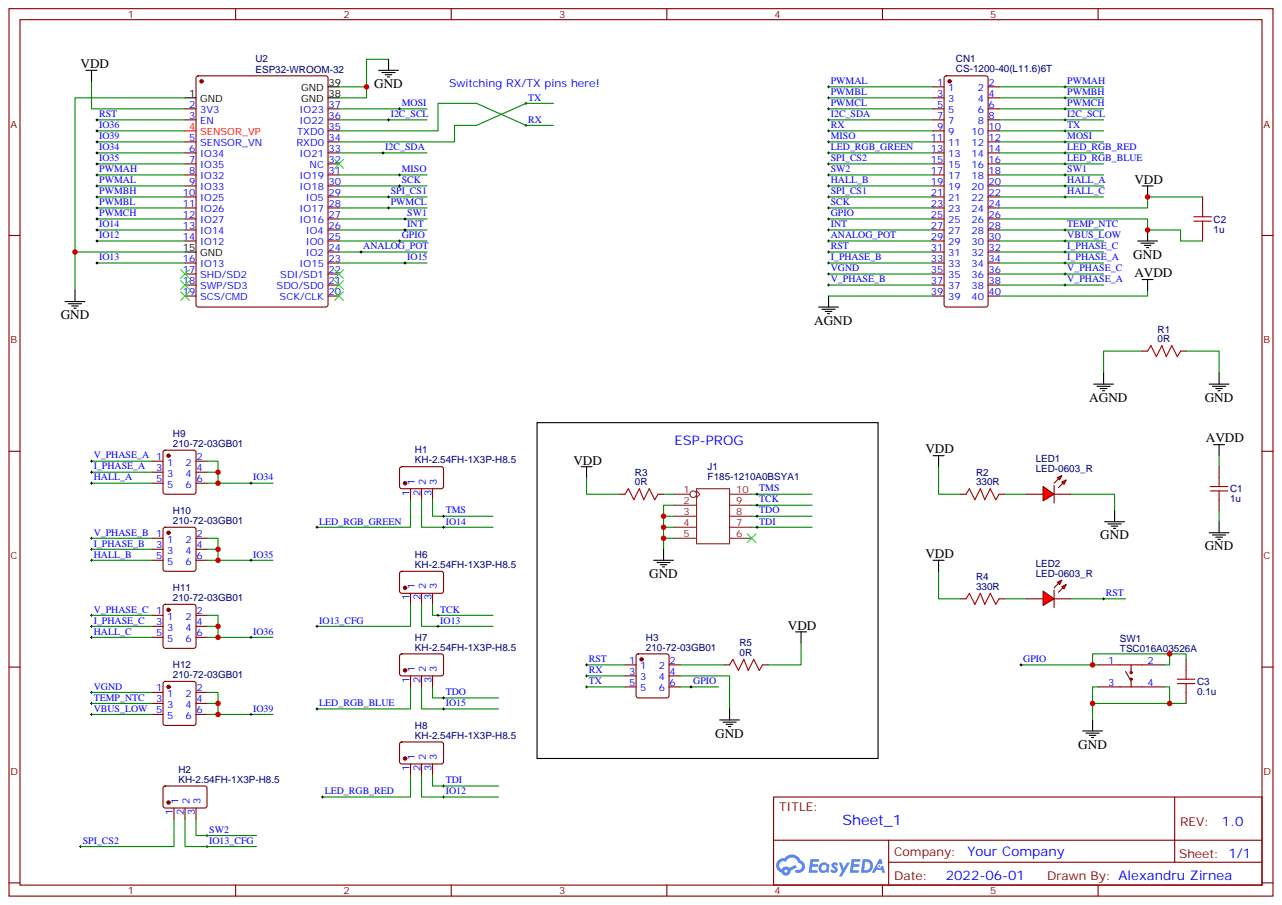
[picture p26: page 1]

Switching RX/TX pins here!

Drawn By: Alexandru Zirnea
