alexzirnea/bldc_motor_driver_platform/Hardware/OrCad Project/power_board/SCH/bldc_motor_driver.pdf

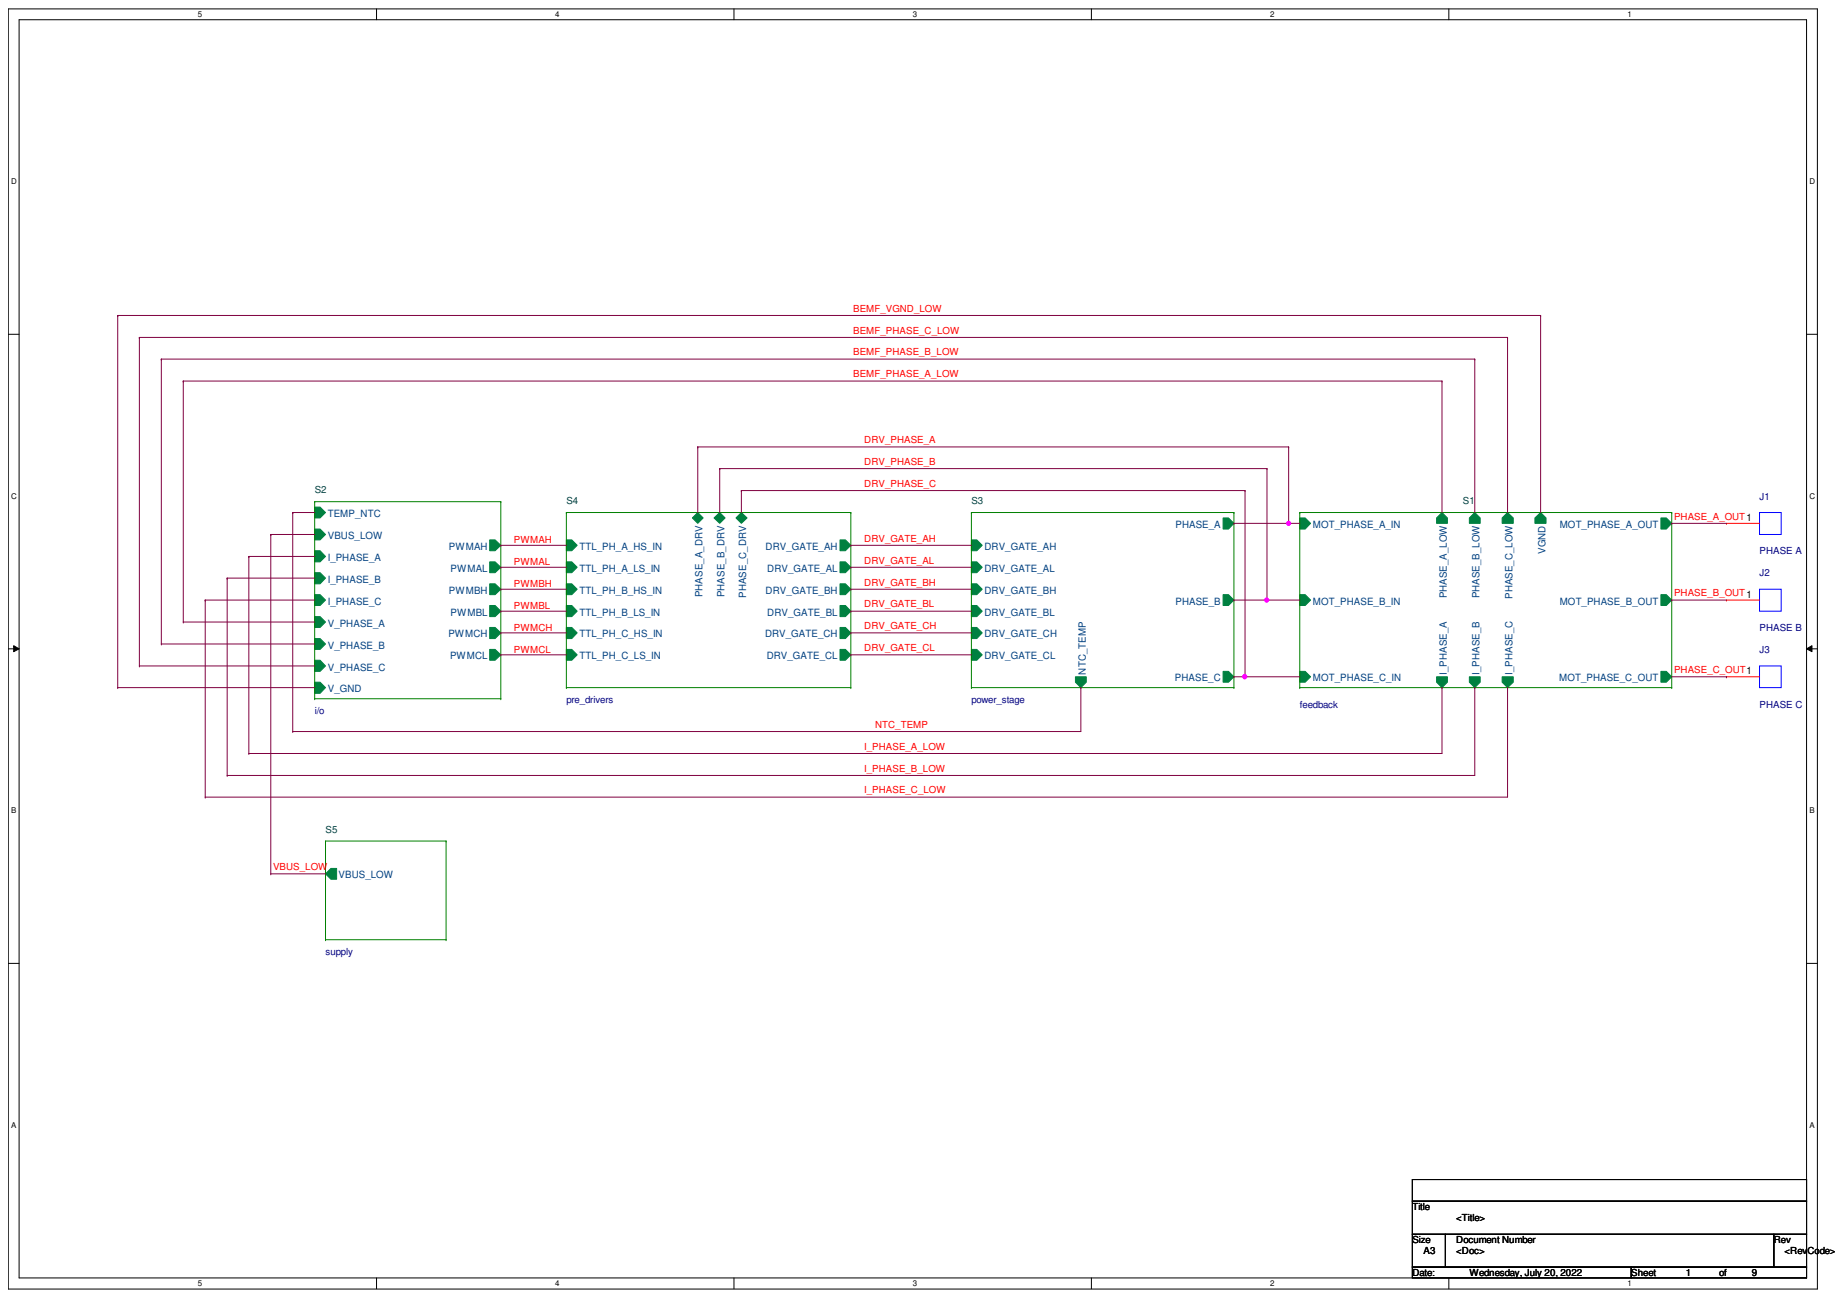
[picture p27: page 1]
Title; Size; Document Number; Rev; Date:; Sheet; <Doc>; <RevCode>; <Title>; 9Wednesday, July 20, 2022; PHASE A; pre_drivers; TTL_PH_A_LS_IN; TTL_PH_A_HS_IN; TTL_PH_B_LS_IN; TTL_PH_B_HS_IN; TTL_PH_C_LS_IN; TTL_PH_C_HS_IN; DRV_GATE_AH; DRV_GATE_AL; DRV_GATE_BH; DRV_GATE_BL; DRV_GATE_CH; DRV_GATE_CL; PHASE_A_DRV; PHASE_B_DRV; PHASE_C_DRV J2; PHASE B; feedback; PHASE_A_LOW; PHASE_B_LOW; PHASE_C_LOW; VGND; MOT_PHASE_C_IN; MOT_PHASE_A_IN; I_PHASE_B; I_PHASE_C; MOT_PHASE_B_IN; I_PHASE_A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

PWMAL | DRV_GATE_AL

PWMBH | DRV_GATE_BH

PWMBL | DRV_GATE_BL

PWMCH | DRV_GATE_CH

PWMCL | DRV_GATE_CL

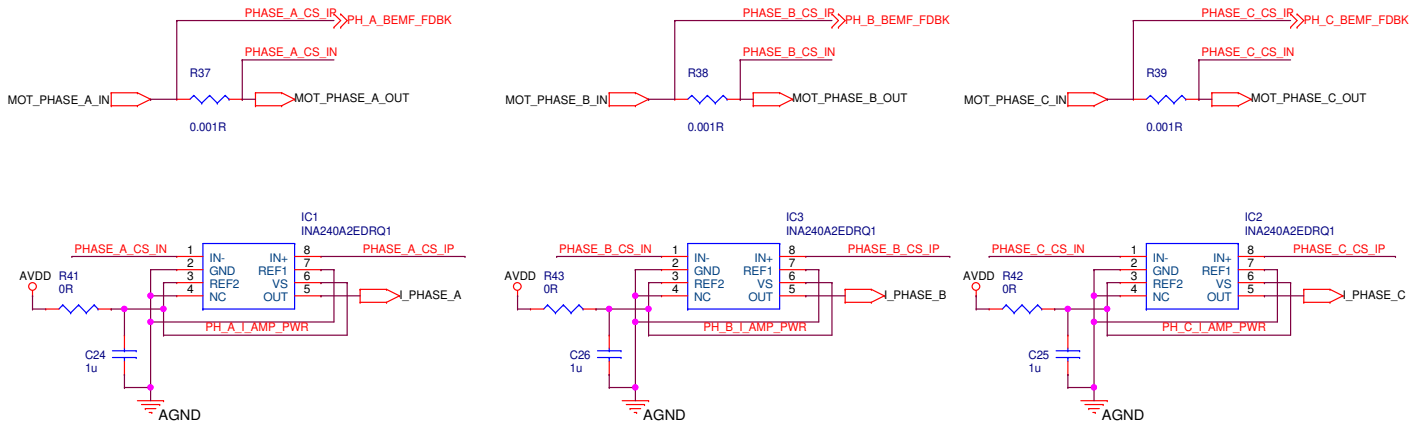
[picture p28: page 2]

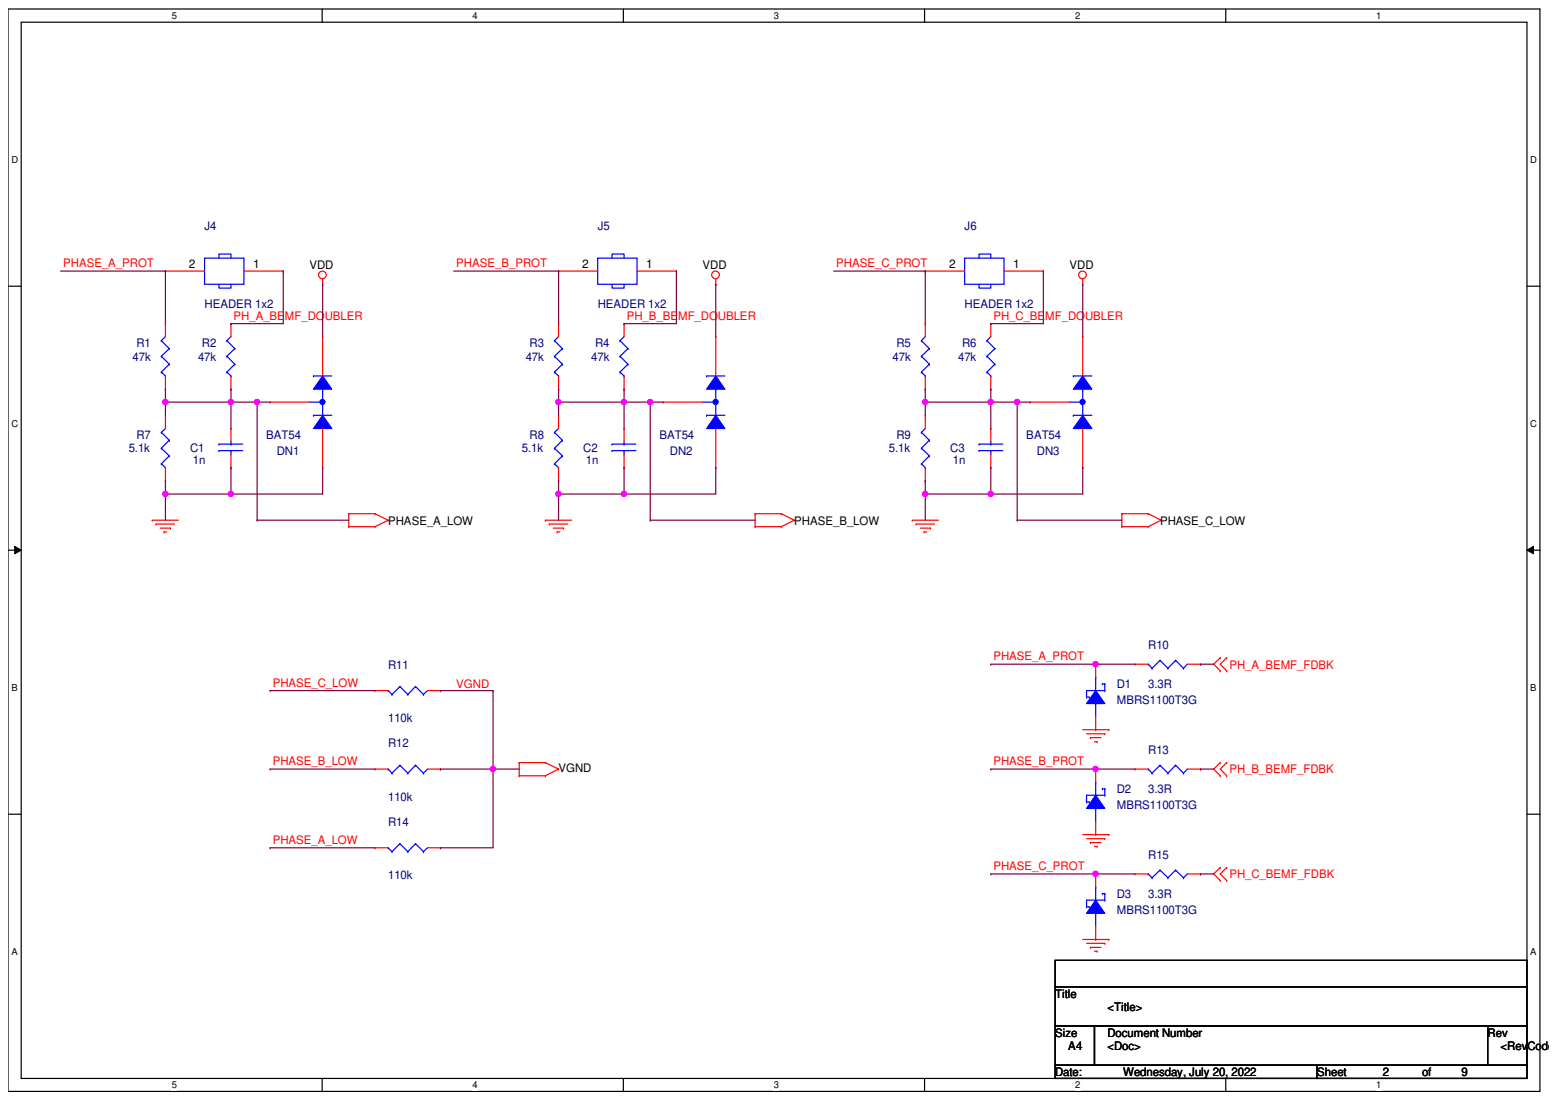
[picture p29: page 3]

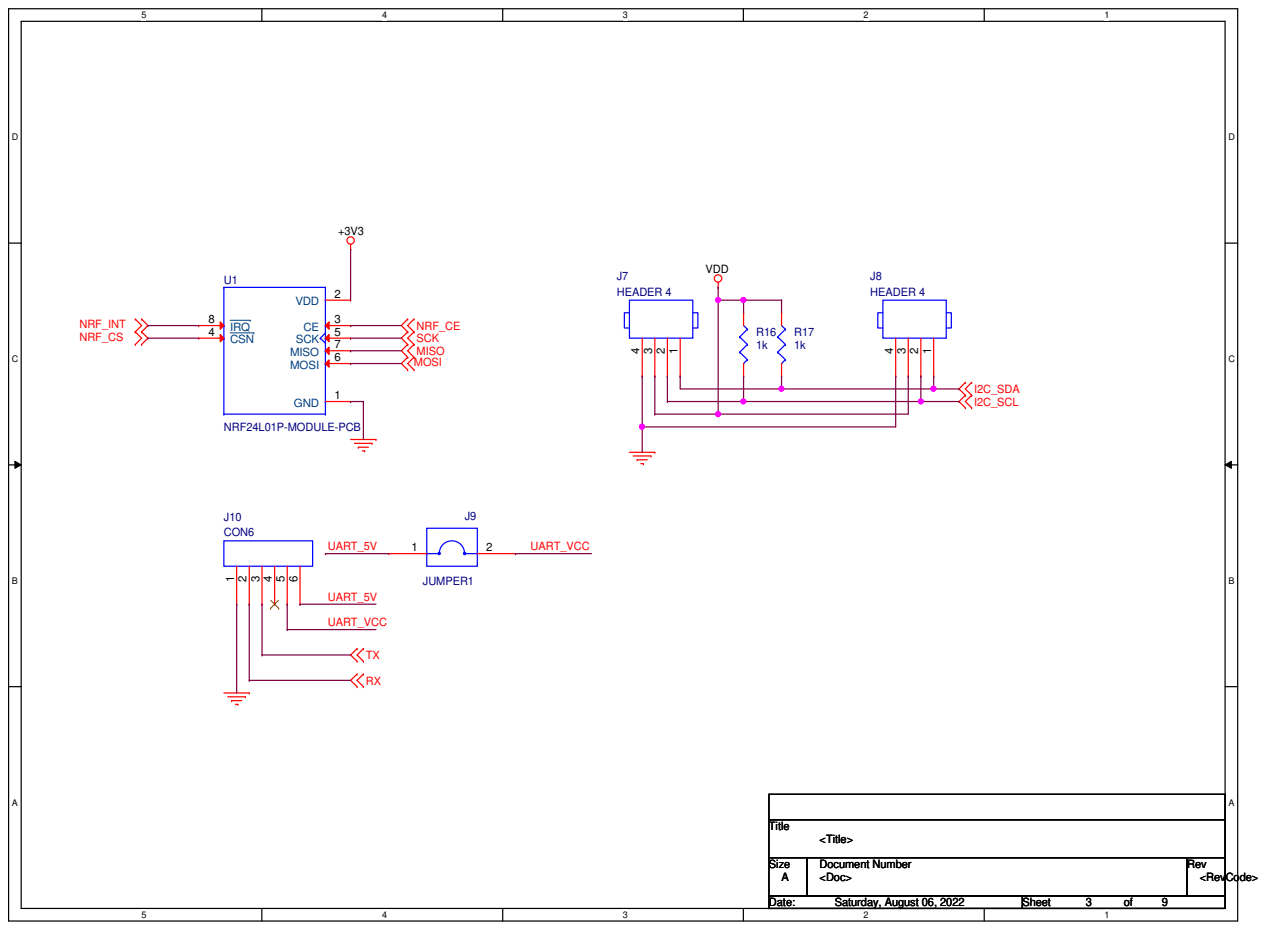
[picture p30: page 4]
VDD; MISO; SCK; NRF_INT; MOSI; NRF_CE; NRF_CS; I2C_SDA I2C_SCL; Title; Size; Document Number; Rev; <Doc>; <RevCode>; <Title>; 9Saturday, August 06, 2022; J10 CON6; J8 HEADER 4; JUMPER1; NRF24L01P-MODULE-PCB; GND; CSN 4; 6 MISO; IRQ 8; J7 HEADER 4; UART_5V; UART_VCC

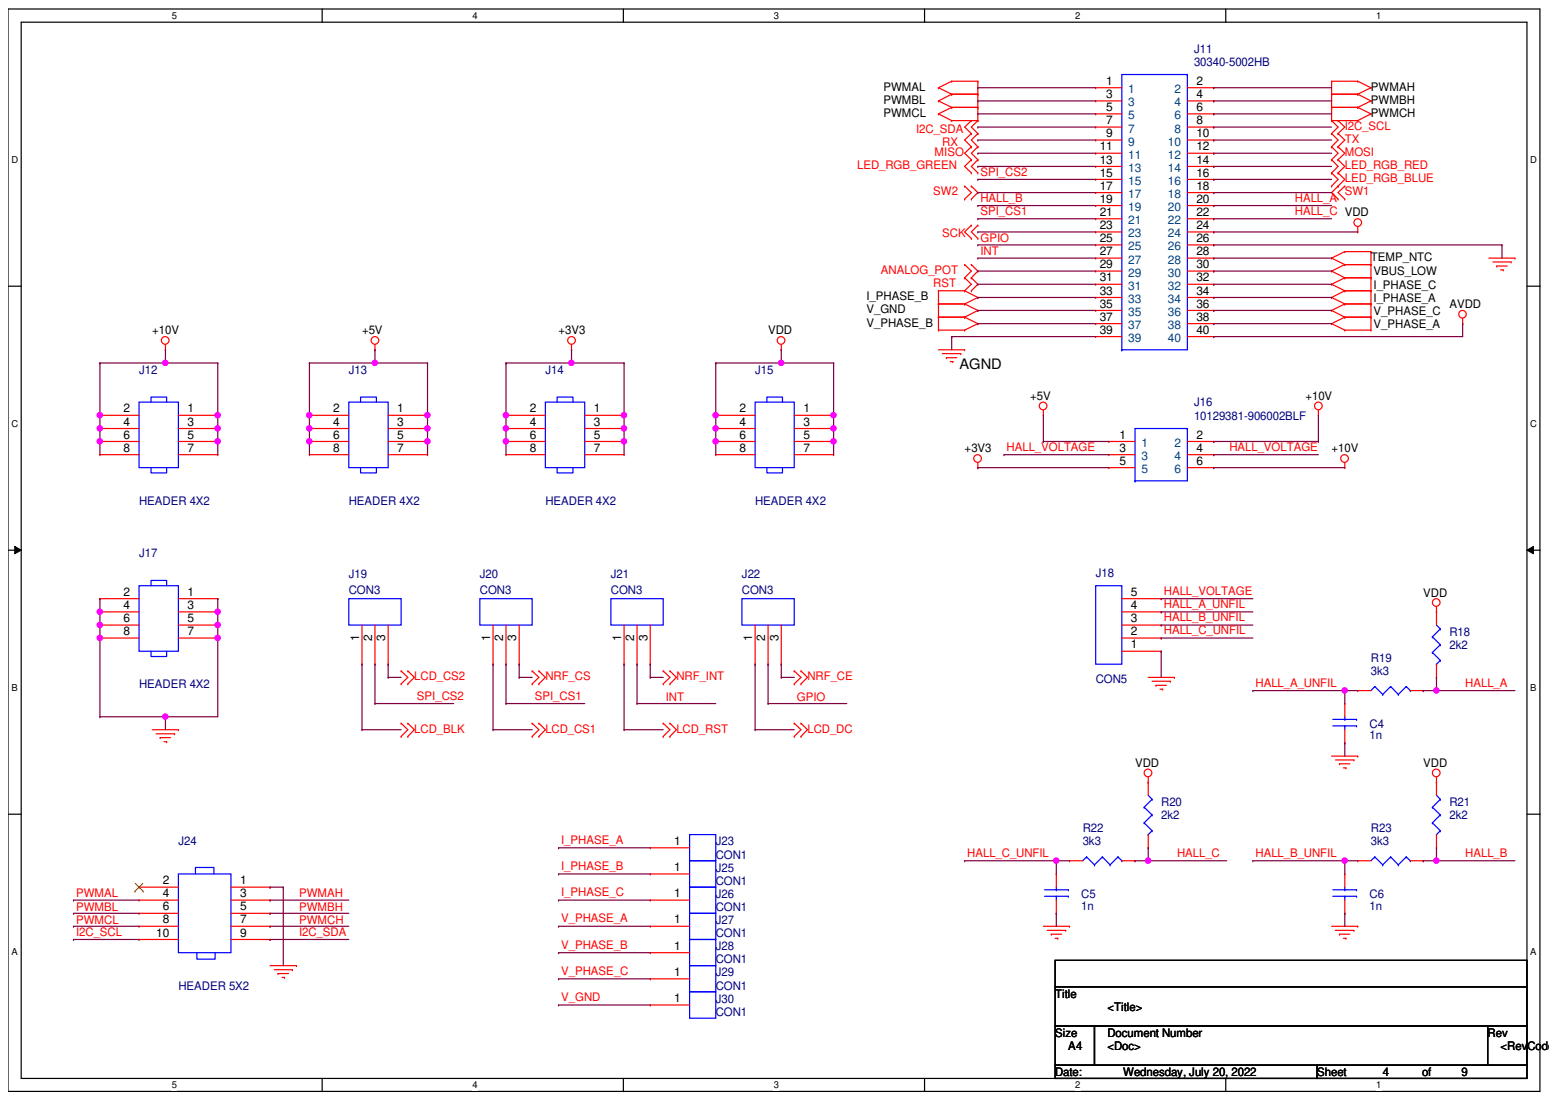
[picture p31: page 5]

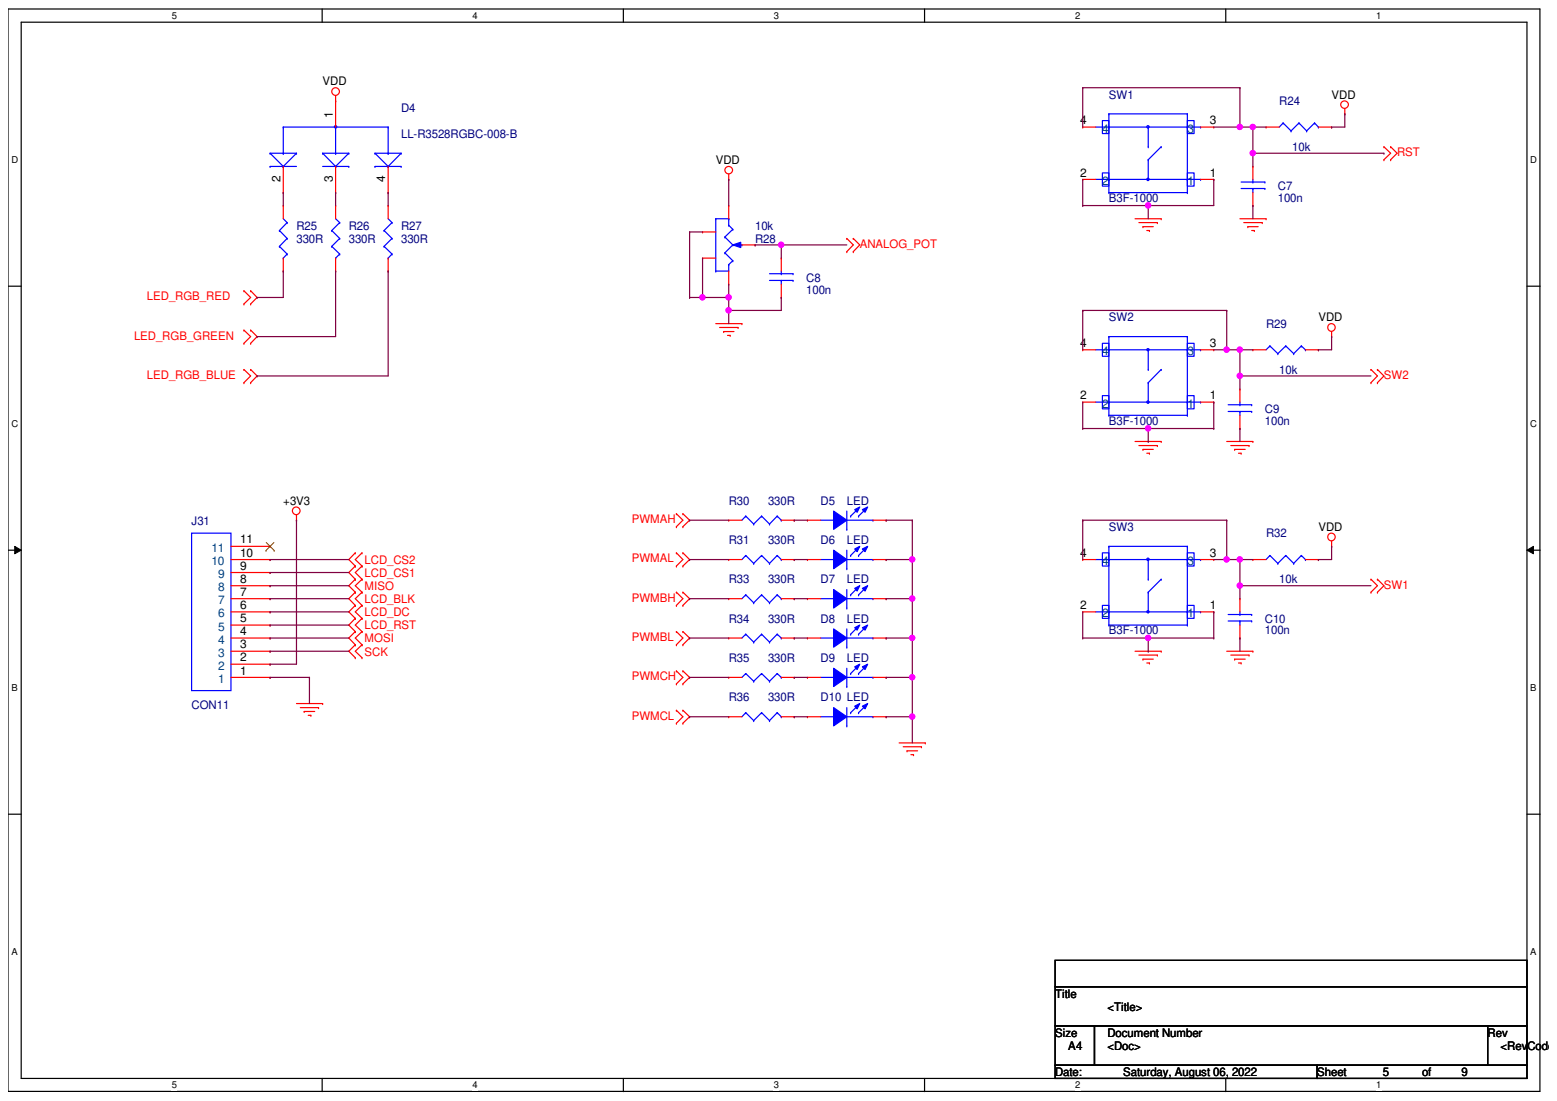
[picture p32: page 6]

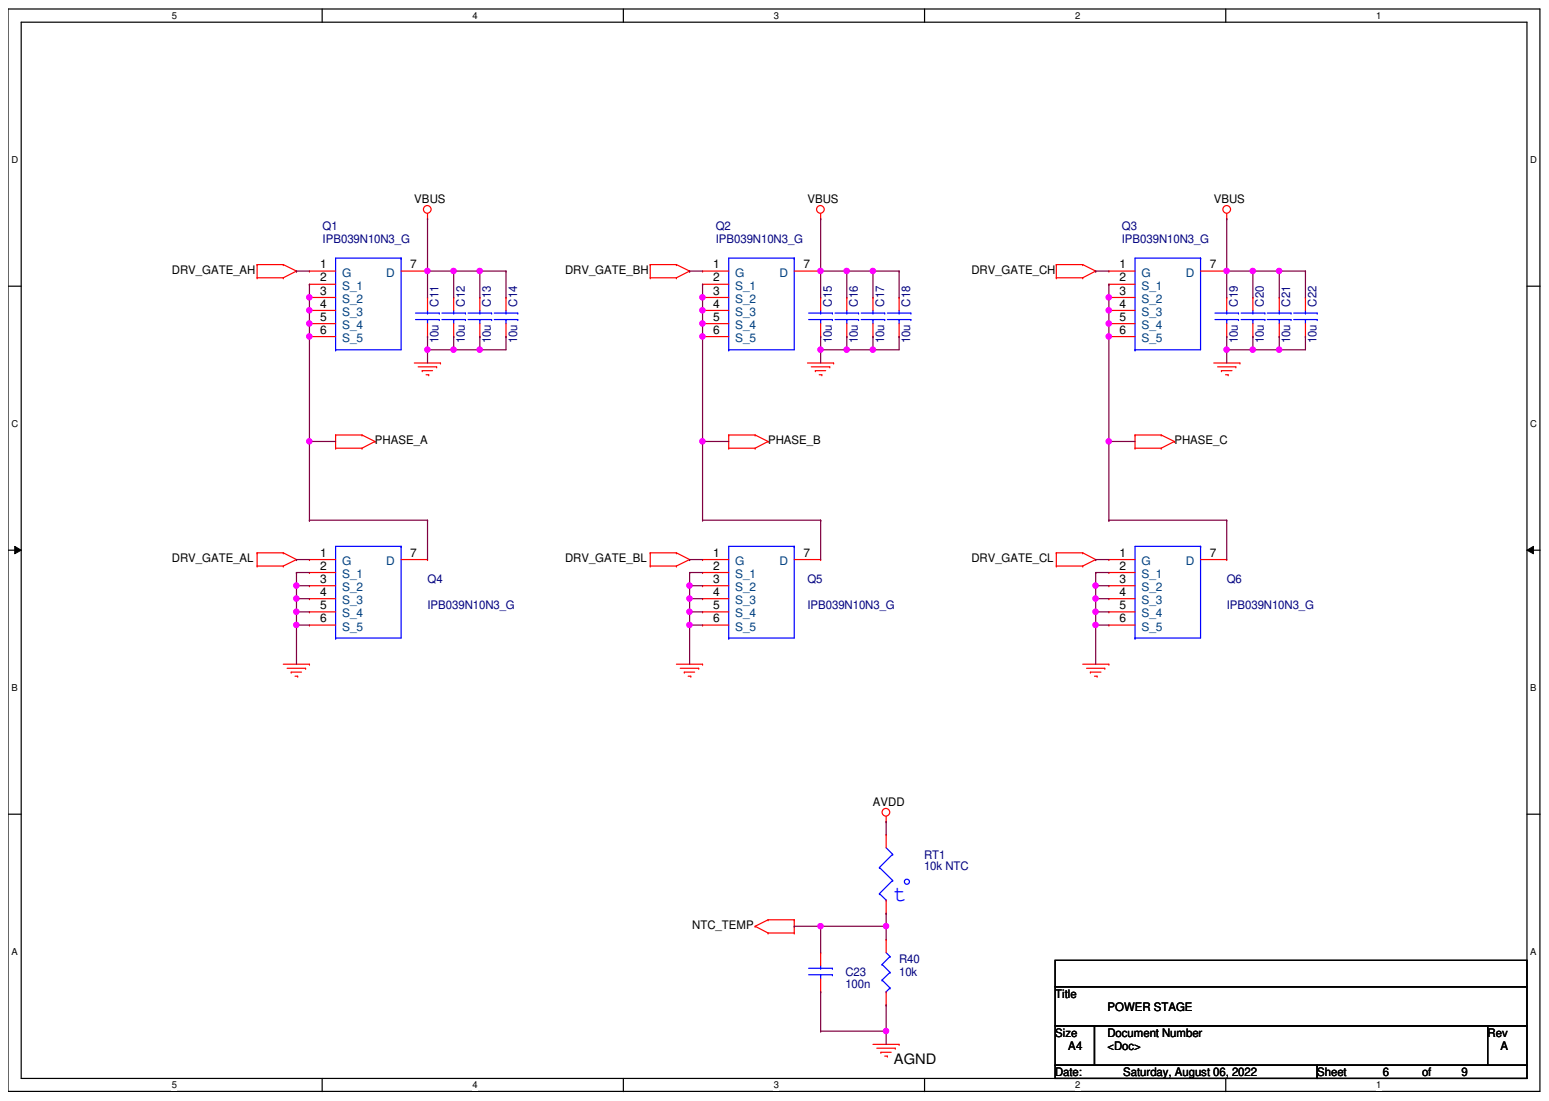
[picture p33: page 7]

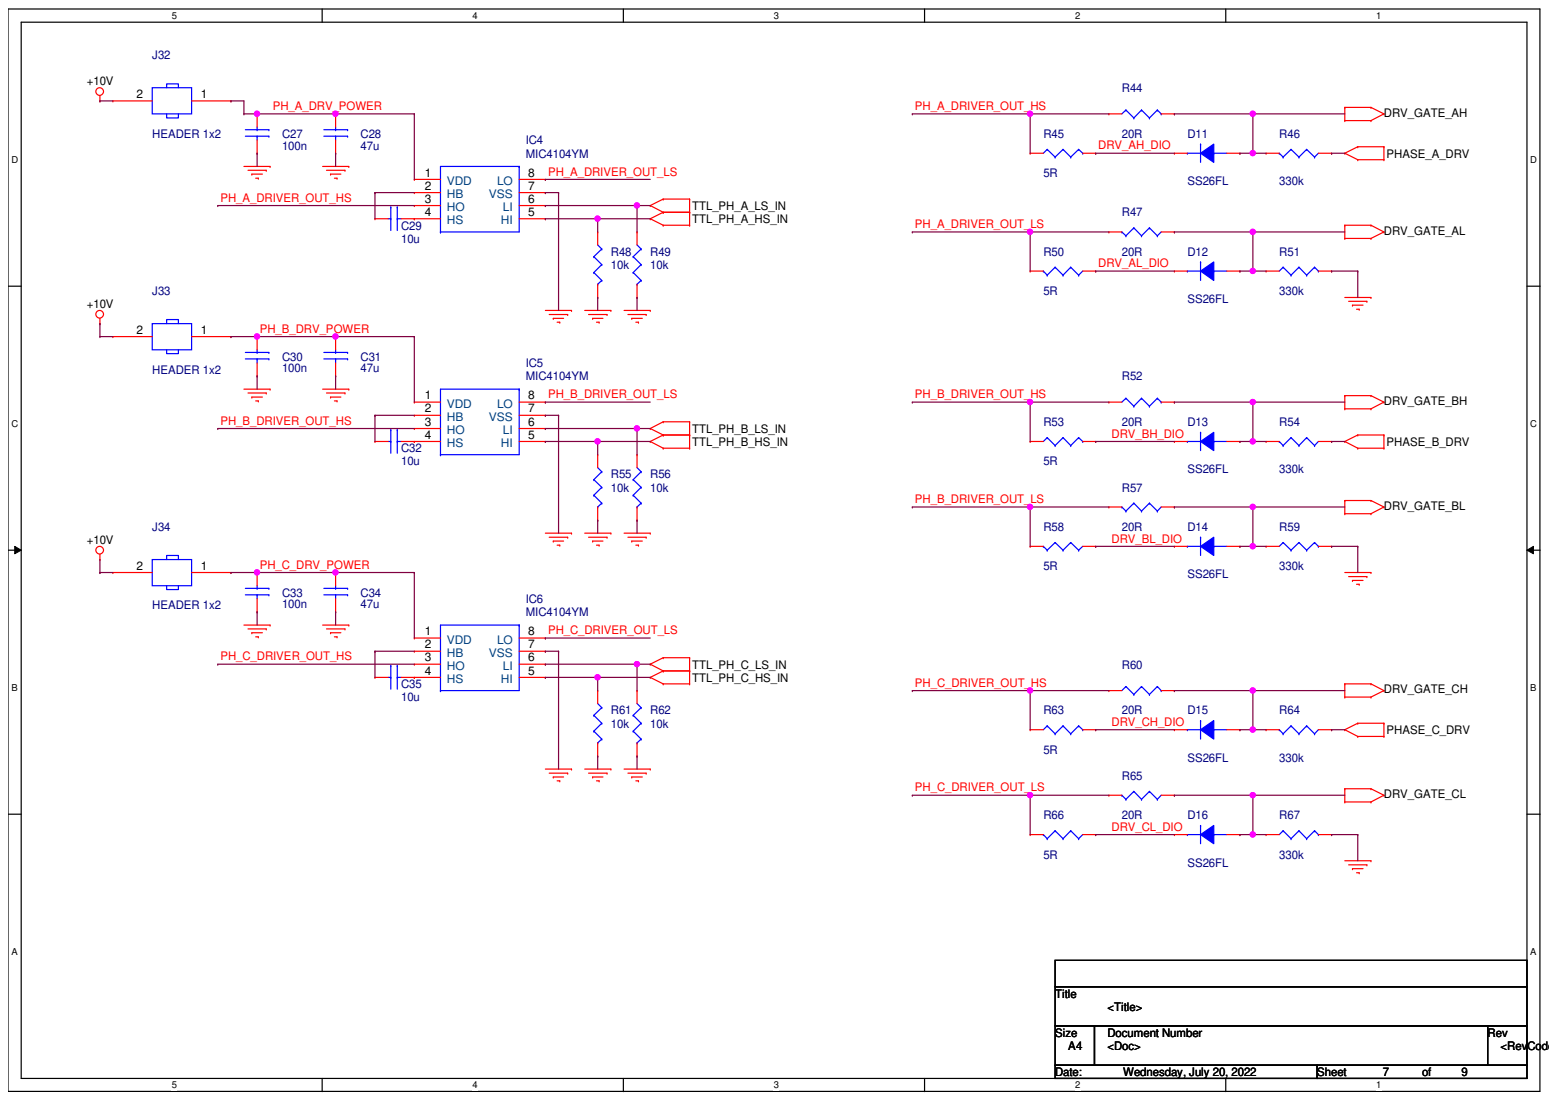
[picture p34: page 8]

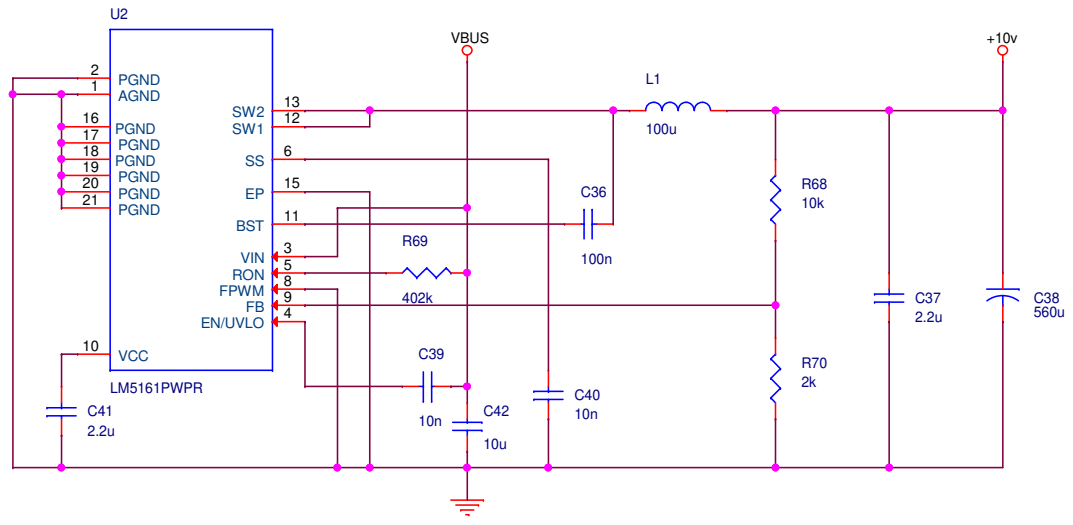
[picture p35: page 9]

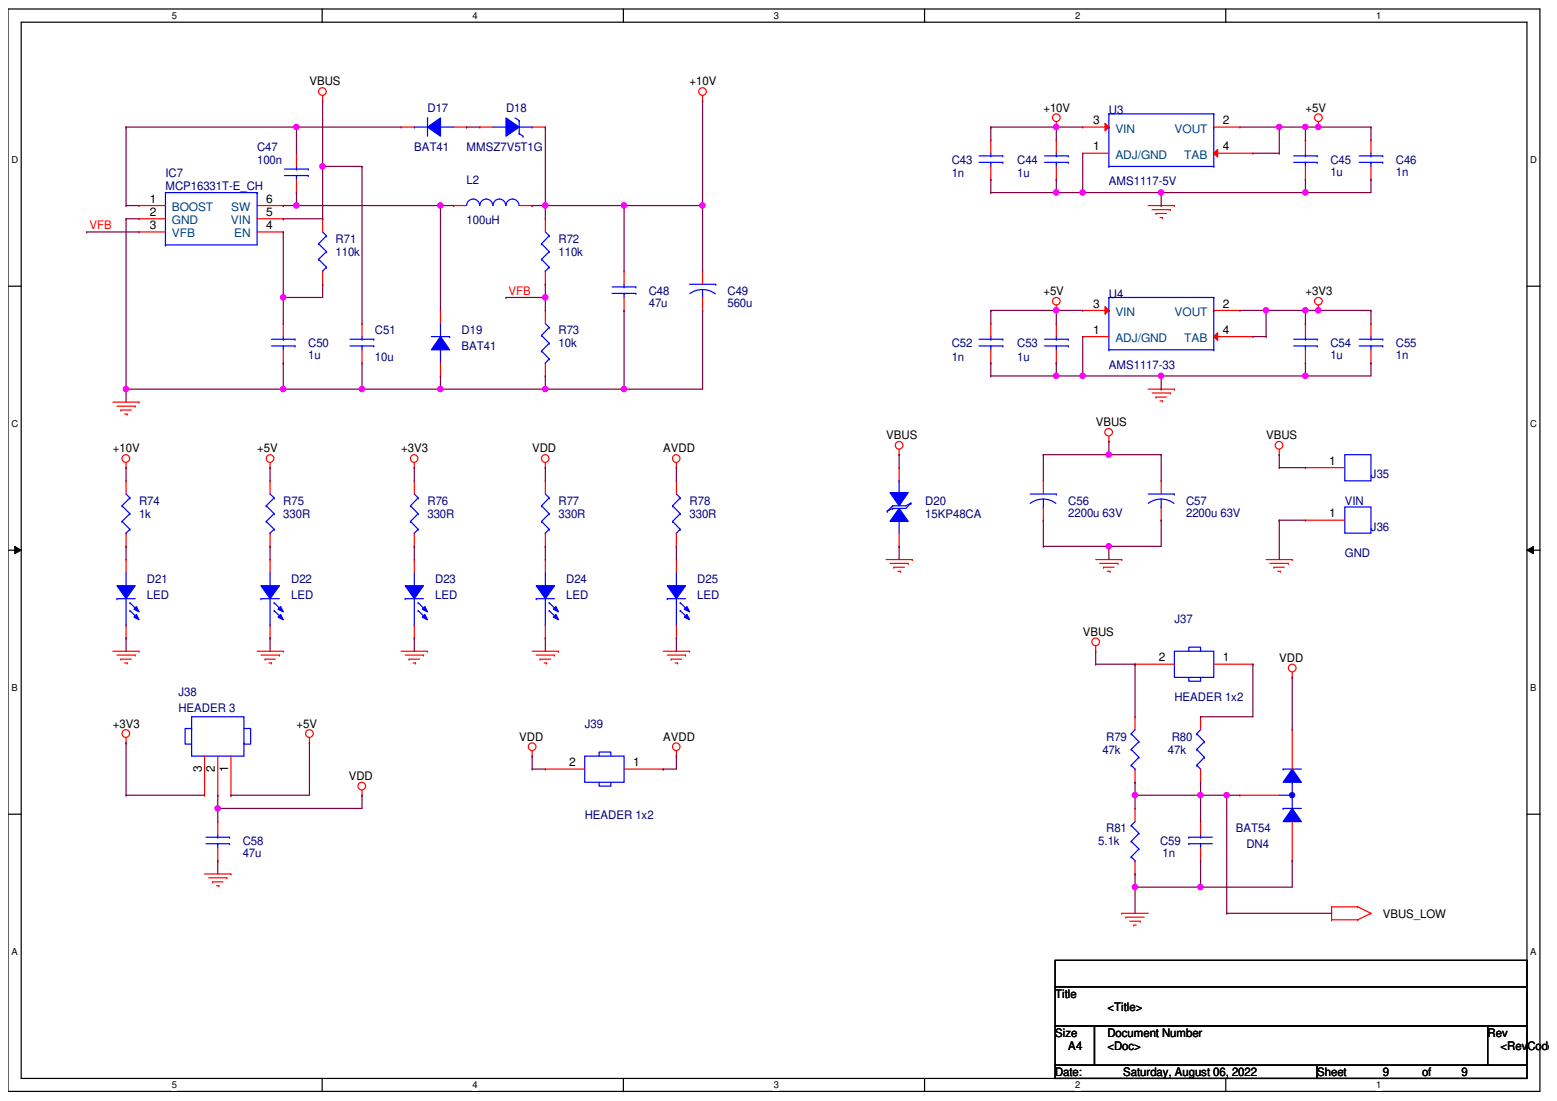
[picture p36: page 10]
