alexzirnea/bldc_motor_driver_platform/(list of files, drawings)

Other design files:
Hardware/OrCad Project/parts/AMS1117-33#0.OLB
Hardware/OrCad Project/parts/AMS1117-33.OLB
Hardware/OrCad Project/parts/B3F-1000.OLB
Hardware/OrCad Project/parts/DR125-101-R.OLB
Hardware/OrCad Project/parts/LL-R3528RGBC-008-B.OLB
Hardware/OrCad Project/parts/LM5161PWPR.OLB
Hardware/OrCad Project/parts/NRF24L01P-MODULE-PCB.OLB
Hardware/OrCad Project/parts/RK09D117000B.OLB
Hardware/OrCad Project/power_board/SCH/BLDC_MOTOR_DRIVER.DSN
Hardware/OrCad Project/power_board/SCH/bldc_motor_driver.opj
Hardware/OrCad Project/power_board/SCH/Symbol_Lib/BLDC_MOTOR_DRIVER_LIB.OLB
Hardware/PIM/ATMEGA_4808/EasyEDA Project/PCB_PCB_ATMEGA4808_BLDC_PIM_2022-08-06.json
Hardware/PIM/ATMEGA_4808/EasyEDA Project/SCH_ATMEGA4808_BLDC_PIM_2022-08-06.json
Hardware/PIM/ESP32-WROOM-32E/EasyEDA Project/PCB_PCB_ESP32_BLDC_PIM_2022-08-06.json
Hardware/PIM/ESP32-WROOM-32E/EasyEDA Project/SCH_ESP32_BLDC_PIM_2022-08-06.json
