alexzirnea/bldc_motor_driver_platform/Software/sample_code/stm32_bldc_haptic/Src/main.c

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

/* Includes ------------------------------------------------------------------*/
#include "main.h"

/* USER CODE BEGIN Includes */
#include "AS5600.h"
#include "motor_control.h"
#include <stdio.h>
/* USER CODE END Includes */

I2C_HandleTypeDef hi2c2;

TIM_HandleTypeDef htim1;
TIM_HandleTypeDef htim2;

UART_HandleTypeDef huart2;
DMA_HandleTypeDef hdma_usart2_tx;

/* USER CODE BEGIN PV */
AS5600_TypeDef hAS5600;
/* USER CODE END PV */

void SystemClock_Config(void);
static void MX_GPIO_Init(void);
static void MX_DMA_Init(void);
static void MX_TIM1_Init(void);
static void MX_TIM2_Init(void);
static void MX_I2C2_Init(void);
static void MX_USART2_UART_Init(void);
/* USER CODE BEGIN 0 */
uint16_t as5600_angle = 0;
/* USER CODE END 0 */

/**
  * @brief  The application entry point.
  * @retval int
  */
int main(void)
{
  /* USER CODE BEGIN 1 */
  hAS5600.i2cHandle = &hi2c2;
  hAS5600.i2cAddr = 0x36<<1;
  uint16_t raw_angle = 0;
  /* USER CODE END 1 */
  

  /* MCU Configuration--------------------------------------------------------*/

  /* Reset of all peripherals, Initializes the Flash interface and the Systick. */
  HAL_Init();

  /* USER CODE BEGIN Init */
  MOTOR_init(htim1, huart2);
  /* USER CODE END Init */

  /* Configure the system clock */
  SystemClock_Config();

  /* Initialize all configured peripherals */
  MX_GPIO_Init();
  MX_DMA_Init();
  MX_TIM1_Init();
  MX_TIM2_Init();
  MX_I2C2_Init();
  MX_USART2_UART_Init();
  /* USER CODE BEGIN 2 */
 // HAL_TIM_Base_Start_IT( &htim1 );
  AS5600_Init(&hAS5600);
    __HAL_TIM_SET_COMPARE( &htim1, TIM_CHANNEL_1, 512 );
  	__HAL_TIM_SET_COMPARE( &htim1, TIM_CHANNEL_2, 512 );
  	__HAL_TIM_SET_COMPARE( &htim1, TIM_CHANNEL_3, 512 );
    HAL_TIM_PWM_Start( &htim1, TIM_CHANNEL_1 );
    HAL_TIM_PWM_Start( &htim1, TIM_CHANNEL_2 );
    HAL_TIM_PWM_Start( &htim1, TIM_CHANNEL_3 );
    HAL_TIMEx_PWMN_Start( &htim1, TIM_CHANNEL_1 );
    HAL_TIMEx_PWMN_Start( &htim1, TIM_CHANNEL_2 );
    HAL_TIMEx_PWMN_Start( &htim1, TIM_CHANNEL_3 );
    HAL_TIM_Base_Start_IT(&htim2);
  /* USER CODE END 2 */

  /* Infinite loop */
  /* USER CODE BEGIN WHILE */
    //__disable_irq();
  while (1)
  {
	  AS5600_GetRawAngle(&hAS5600, &raw_angle);

	  as5600_angle = raw_angle;
	 // __enable_irq();
    /* USER CODE END WHILE */

    /* USER CODE BEGIN 3 */
  }
  /* USER CODE END 3 */
}

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
/* USER CODE BEGIN 4 */
void HAL_TIM_PeriodElapsedCallback(TIM_HandleTypeDef *htim)
{

   // MOTOR_process(as5600_angle);

}
/* USER CODE END 4 */
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
