alexzirnea/bldc_motor_driver_platform/Software/sample_code/stm32_bldc_haptic/stm32_bldc_haptic.ioc

Mcu.UserName=STM32F103C8Tx
PA10.Signal=S_TIM1_CH3
PA13.Signal=SYS_JTMS-SWDIO
PA14.Signal=SYS_JTCK-SWCLK
PA2.Signal=USART2_TX
PA3.Signal=USART2_RX
PA7.Signal=TIM1_CH1N
PA8.Signal=S_TIM1_CH1
PA9.Signal=S_TIM1_CH2
PB0.Signal=TIM1_CH2N
PB1.Signal=TIM1_CH3N
PB10.Signal=I2C2_SCL
PB11.Signal=I2C2_SDA
PC13-TAMPER-RTC.GPIO_Label=LED
PC13-TAMPER-RTC.Signal=GPIO_Output
PD0-OSC_IN.Signal=RCC_OSC_IN
PD1-OSC_OUT.Signal=RCC_OSC_OUT
