alexzirnea/bldc_motor_driver_platform/Software/test_firmwares/4808_bldc.X/app.h

/* 
 * File:   app.h
 * Author: Alexandru Zirnea
 *
 * Created on March 18, 2021, 6:08 PM
 */

#ifndef APP_H
#define	APP_H

#ifdef	__cplusplus
extern "C" {
#endif

    void APP_run();
    void APP_init();

#ifdef	__cplusplus
}
#endif

#endif	/* APP_H */
