alexzirnea/bldc_motor_driver_platform/Software/test_firmwares/4808_bldc.X/utils.h

/* 
 * File:   utils.h
 * Author: Alex Zirnea
 *
 * Created on August 24, 2022, 12:26 PM
 */

#ifndef UTILS_H
#define	UTILS_H

#ifdef	__cplusplus
extern "C" {
#endif

long map(long x, long in_min, long in_max, long out_min, long out_max);

#ifdef	__cplusplus
}
#endif

#endif	/* UTILS_H */
