alexzirnea/bldc_motor_driver_platform/(commit log)

2021-04-01 Added Footprints from @andreidaescu to their correct path in the repo. Edited gitignore
    [20_2x10_right_angle_connector.psm, 3_pin_header_standard.psm, 5_pin_header_standard.psm, 6_pin_header_standard.psm, b1047as-680m-p3.psm, css2h-3920r.psm, dio_ss26fl.psm, diom5436x247n.psm]
2021-04-01 Added OrCad project files
    [BLDC_MOTOR_DRIVER.DSN, bldc_motor_driver.opj]
2021-10-14 Added pin mapping excel file
    [Connector_Pin_Mapping.xlsx]
2021-10-18 Relocate some files. Gitignore update.
    [10129378-903001BLF.stl, 10129378-903001BLF.stp, 10129381-906002BLF.stl, 10129381-906002BLF.stp, 20_2x10_right_angle_connector.psm, 30340-5002HB.stl, 30340-5002HB.stp, 3_pin_header_standard.psm]
2021-10-18 Added stm32 haptic sample code project
2022-05-08 Hardware updates
    [BLDC_MOTOR_DRIVER.DSN, BLDC_MOTOR_DRIVER_LIB.OLB, bldc_motor_driver.opj]
2022-05-16 Power board schematic almost finished
    [AMS1117-3.3.STEP, AMS1117-33#0.OLB, AMS1117-33.OLB, BLDC_MOTOR_DRIVER.DSN, BLDC_MOTOR_DRIVER_LIB.OLB, Connector_Pin_Mapping.xlsx, Design1.opj, LL-R3528RGBC-008-B.OLB]
2022-05-17 Partly finish the schematic
    [BLDC_MOTOR_DRIVER.DSN]
2022-05-17 Fix schematic electrical issues
    [BLDC_MOTOR_DRIVER.DSN, bldc_motor_driver.opj]
2022-05-19 Footprint updates. Cleanup
    [20_2x10_right_angle_connector.psm, 3_pin_header_standard.psm, 5_pin_header_standard.psm, 6_pin_header_standard.psm, BLDC_MOTOR_DRIVER.DSN, CAPC5750X330N.STEP, DESIGN1.DSN, DIOAD885W125L910D885.STEP]
2022-05-19 Add new footprints
    [BLDC_MOTOR_DRIVER.DSN, SLF12575T-101M1R9-PF.STEP, indp125125x785n.psm]
2022-05-20 Schematic updates
    [B3F-1000.OLB, B3F-1000.STEP, BLDC_MOTOR_DRIVER.DSN, BLDC_MOTOR_DRIVER_LIB.OLB, DR125-101-R.OLB, bldc_motor_driver.opj, indm1250x1250x600.psm, power_pad.psm]
2022-05-22 PCB placement completed. Some schematic updates
    [22205C105KAT1A.STEP, BLDC_MOTOR_DRIVER.DSN, bldc_motor_driver.opj, capc5750x229n.psm, diom5436x247n.psm, ili9341_2_8inch.psm, motherboard.brd, pg-to263-3.psm]
2022-05-24 Components arranged. Silkscreen orientation almost done.
    [BLDC_MOTOR_DRIVER.DSN, bldc_motor_driver.opj, motherboard.brd]
2022-05-26 Route drivers
    [BLDC_MOTOR_DRIVER.DSN, bldc_motor_driver.opj, motherboard.brd]
2022-07-16 Route cleanup. Various improvements
    [BLDC_MOTOR_DRIVER.DSN, bldc_motor_driver.opj, motherboard.brd]
2022-07-19 Almost done
    [BLDC_MOTOR_DRIVER.DSN, bldc_motor_driver.opj, motherboard.brd]
2022-07-20 First revision done
    [BLDC_MOTOR_DRIVER.DSN, bldc_motor_driver.opj, motherboard.brd, power_pad.psm]
2022-08-06 Add PIMs sources, BOM and manufacturing files
    [BOM.xlsx, PCB_PCB_ATMEGA4808_BLDC_PIM_2022-08-06.json, PCB_PCB_ESP32_BLDC_PIM_2022-08-06.json, SCH_ATMEGA4808_BLDC_PIM_2022-08-06.json, SCH_ESP32_BLDC_PIM_2022-08-06.json]
2022-08-06 Add motherboard BOM. Cleanup
    [BLDC_MOTOR_DRIVER.DSN, BOM.xlsx, bldc_motor_driver.opj]
2022-08-06 Add schematic in PDF format
2022-08-23 Add RGB functionality. Stability improvements
    [app.c, hal.c, hal.h, mc_drive.c]
2022-08-23 Tie RGB functionality to motor control. Switch to XC8 with O3 optimizations
